jacob-rn-wallace/jpl-nanorover/README.md

<p align="center">
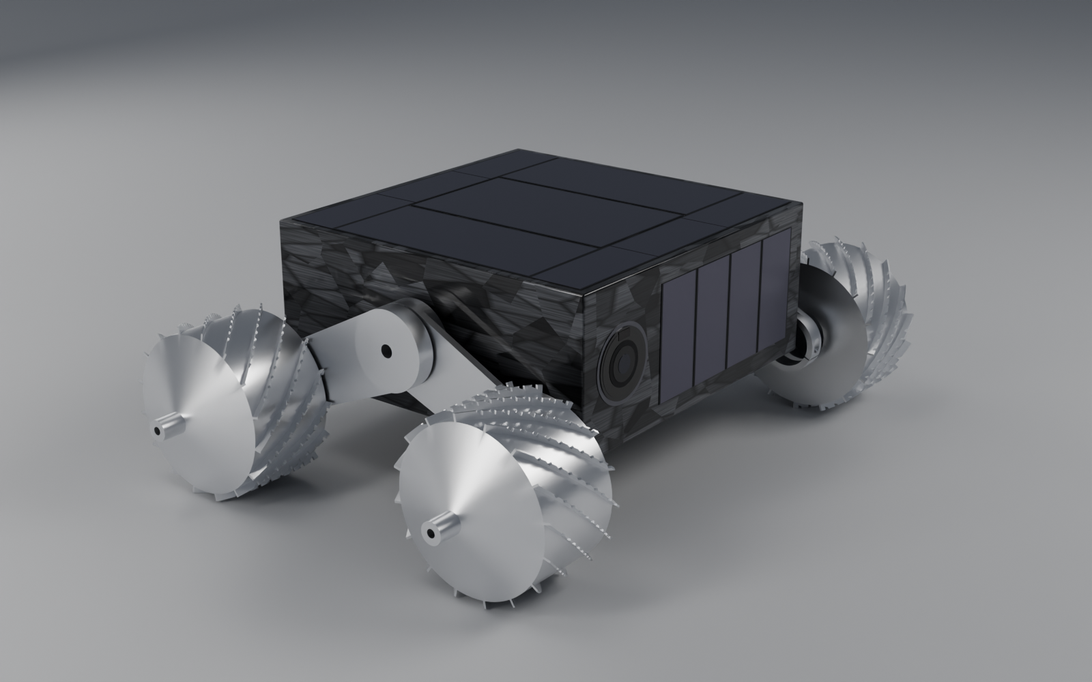
[picture p1: docs/images/rover-hero.png]
A render of the interpreted JPL nanorover: a 140 x 140 x 60 mm forged-carbon body with near-black solar cells on the lids and end faces, a round camera window on the end face, and four aluminium cleated wheels on 70 mm struts
  
</p>

# jpl-nanorover

Research toward an open replica of the JPL nanorover, the small four-wheeled asteroid rover designed for the Japanese MUSES-C (Hayabusa) sample-return mission and cancelled by NASA in November 2000.

The project is now an **interpretation** of the nanorover rather than a strict replica: it keeps the original's overall character, its 140 x 140 x 60 mm body, 70 mm struts and 65 mm wheels and its non-science functions (driving on four wheels, posing its four struts independently, self-righting, solar power and a camera), and chooses functionality, aesthetics and the spirit of mid-1990s to early-2000s hobby and academic robotics (a single controller, smart sensors on a serial link, a simple radio) over copying the originals' details. It is a teleoperated rover: it sends compact sensor data to an operator console that builds a low-fidelity 3D map, and sends a photograph on request. Spaceflight readiness is not a goal, and neither is the science payload (the IR spectrometer and so on) beyond what is needed to look right.

> **Status (2026-11-14): design on paper and in CAD; nothing is built or ordered, and purchasing is deferred.** The drivetrain is designed and modelled (Feetech servos at the hub, Pololu gearmotors in aluminium wheels). The body is being redesigned in forged carbon: it exists as a solid block with the components cut out of it, and a render stand-in (the Hammond box in the older assembly CAD is superseded). Most of the rover's own hardware is now named, with each figure tagged by how well it is sourced: [`docs/hardware-spec.md`](docs/hardware-spec.md) (controller, radio, battery, charger, sensors, drivers, camera window) and [`docs/mechanical-spec.md`](docs/mechanical-spec.md) (retention, couplings, cables, strut stops). The operator-console simulation runs in a browser. Scale, how the body is made, the lid joint and the end use are undecided; several details are labelled assumptions, not published figures.

## Target
The reference units are the two built JPL prototypes in the photographs and videos: a silver-bodied unit (a round imaging window and a sealed-beam headlamp on one end face) and a black-bodied unit (a square camera window), which share their struts and wheels. Measured against a quarter in one photo, the black unit is about
139 x 139 mm on top with wheels about 59 mm across and struts about 76 mm, and the silver unit about 125 x 140 x 55 mm. The MUSES-CN papers give a 14 x 14 x 6 cm body, 6.5 cm wheels and 7 cm struts, and win by default where the units do not agree with each other
independently (`docs/design-comparison.md`); the units differ from the papers by 8 to 11%. Solar cells on four of six faces and about 1.3 kg stay as published reference. Wheel tread, strut cross-section, hub detail and finish are not published and are scaled from photographs.
Every figure is marked with how well it is sourced, and conflicting figures are listed.

## What's here
| Path | Contents |
|---|---|
| [`docs/jpl-nanorover-literature.md`](docs/jpl-nanorover-literature.md) | Annotated bibliography, specification table with verification levels, image sources and the list of conflicting figures |
| [`docs/body-spec.md`](docs/body-spec.md), [`strut-spec.md`](docs/strut-spec.md), [`wheel-spec.md`](docs/wheel-spec.md) | The CAD design decisions: what is sourced, what is measured from the photo, what is assumed, and the checks |
| [`docs/handover.md`](docs/handover.md) | Where the project stands: sources, decisions, open questions, CAD status, corrections made and next steps |
| [`docs/hardware-spec.md`](docs/hardware-spec.md), [`mechanical-spec.md`](docs/mechanical-spec.md) | The rover's chosen hardware (parts, sources, what is verified and what is assumed) and the mechanical details (retention, couplings, seals, cables, strut stops, the lid joint) |
| [`docs/body-redesign.md`](docs/body-redesign.md) | The carbon body: layout, cells, windows, mass, the block-with-cavities method; scripts in [`hardware/body/`](hardware/body/) |
| [`docs/positioning.md`](docs/positioning.md) | Absolute positioning options (ultrasonic, Lighthouse via the solar cells, GNSS dropped) and the antennas |
| [`docs/drivetrain-spec.md`](docs/drivetrain-spec.md), [`chassis-simulation.md`](docs/chassis-simulation.md) | The drivetrain (torque and mass budget, motors, coaxial hub) and the planar chassis simulation (stances, tipping, self-righting) |
| [`docs/blender-render.md`](docs/blender-render.md), [`render-jobs.md`](docs/render-jobs.md) | The Blender renders (setup, what is modelled) and the job list that hands renders from the modelling session to the render session |
| [`docs/design-comparison.md`](docs/design-comparison.md) | The three designs in the sources (the published design and the two photographed units), side by side, with what the CAD is today and what choosing would change |
| [`docs/toy-version-notes.md`](docs/toy-version-notes.md) | A side discussion: could a stripped nanorover have been a toy around 2000, and should the project pivot (with sources) |
| [`docs/smaller-than-nanorover.md`](docs/smaller-than-nanorover.md) | A side question: what the sources say about rovers smaller than the nanorover (the 10 to 100 g task goal, widget boards) |
| [`docs/era-of-robotics.md`](docs/era-of-robotics.md) | Research on the late 1990s to early 2000s robotics scene (Handy Board, Rug Warrior, Stamp, RCX, BEAM, CMUcam, Brooks): what the "spirit" is, how today differs, candidate design rules |
| [`docs/electronics-concept.md`](docs/electronics-concept.md) | The electronics principle (the spirit of the Handy Board and CMUcam era), what was found for the processor and the camera, and the open decisions |
| [`docs/sim-spec.md`](docs/sim-spec.md), [`sim/`](sim/) | A browser simulation of the operator console (three.js, Vite, TypeScript, modelled on maha-rover's): a fun test of driving the rover through a low-fidelity 3D map with photographs on request; spec, findings and how to run it |
| [`docs/photo-measurements.md`](docs/photo-measurements.md) | Camera solution and measurements (solar cell sizes, wheel) taken from the JPL prototype photograph |
| [`hardware/`](hardware/) | Parametric CAD (build123d, STEP output): [body](hardware/body/), [hub](hardware/hub/hub.py), [struts](hardware/strut/strut.py), [wheels](hardware/wheel/wheel.py), [assembly and renders](hardware/assembly/); power, battery and layout scripts in `hardware/body/` |

## Running the CAD
```
python3 -m venv .venv
.venv/bin/pip install -r hardware/requirements.txt
.venv/bin/python hardware/body/body.py        # then hub/hub.py, strut/strut.py, wheel/wheel.py, assembly/rover.py (the older Hammond-box assembly)
.venv/bin/python hardware/body/layout.py      # the carbon body redesign: placements, mass and balance; then body/block.py (the block with cavities)
python3 hardware/body/power_budget.py         # plain python3 scripts: power_budget.py, battery_sizing.py, hardware/strut/pivot_checks.py
```
Each script prints its checks and writes STEP files to an `out/` folder beside it. Run them from the repository root, in that order (`layout.py` before `block.py`). `body.py` needs Hammond's
1590Z090 STEP file, which is not in this repository (see [`NOTICE.md`](NOTICE.md)); it is read from the private companion repository `jpl-nanorover-private`
cloned beside this one, or from the path in `HAMMOND_1590Z090_STP`. The carbon-body scripts (`layout.py`, `block.py`) do not need it. The Blender renders are described in [`docs/blender-render.md`](docs/blender-render.md); the browser simulation runs with `npm run dev` in [`sim/`](sim/).

## Contributing
Corrections with a primary source are the most valuable contribution, especially dimensions of the hub, wheel and struts, or engineering drawings. Contact with the JPL Robotics group or JPL Archives is the only known route to authoritative dimensions.

The source papers, photographs and video, and Hammond's CAD file, are kept in a separate private repository, `jpl-nanorover-private`, because they belong to their publishers. Contributions to the CAD should come with a source or a measurement for any dimension they change; see [`CLAUDE.md`](CLAUDE.md).

## License model
- **Code** (scripts, tooling) is licensed under **Apache-2.0** (see [`LICENSE`](LICENSE)).
- **Hardware designs** (the CAD scripts and their STEP output), **mechanical documentation and bills of materials** are licensed under **CERN-OHL-S-2.0**, strongly reciprocal (see [`LICENSE-HARDWARE.txt`](LICENSE-HARDWARE.txt)).
- **Documentation** (the notes in `docs/`, READMEs) is licensed under **CC BY 4.0** (see [`LICENSE-DOCUMENTATION.txt`](LICENSE-DOCUMENTATION.txt)).

See [`NOTICE.md`](NOTICE.md) for third-party material. This is an independent hobby project, not affiliated with NASA, JPL or ISAS/JAXA.
