jacob-rn-wallace/jpl-nanorover/docs/hardware-spec.md

# Hardware specification: what is chosen, what is working, what is open

Started 2026-11-13. Goal (owner, 2026-11-13): specify as much of the rover's own hardware as possible. Nothing is ordered, and purchasing is deferred indefinitely (owner), so every part here is a paper choice.

Tags: **owner** = decided by the owner; **working** = my recommendation, accepted by the owner as the working choice; **verified** = figure read from a datasheet or listing (source named); **assumed** = my estimate or memory, unchecked. The old placeholders in `hardware/body/layout.py` still carry assumed sizes and masses.

## 1. Chosen (owner or working)

| Subsystem | Part | Tag | Notes |
|---|---|---|---|
| Controller | **Microchip PIC32MX250F128D (44-pin TQFP or QFN)**, replacing the 28-pin F128B | owner (family), pin count working (2026-11-13) | Same family, 128 KB flash and 32 KB RAM, 13 analogue inputs, 34 I/O, five output-compare modules (verified in the family datasheet, section 7). Current 20 mA typical at 40 MHz (verified, Table 29-5). See 6 and 7. |
| Radio | Digi XBee 3 802.15.4, non-PRO, U.FL (XB3-24AUM-J) | owner | 40 mA transmit at +8 dBm, 15 mA receive, 2 uA power-down (not from the full datasheet table). Not ordered. |
| Antenna | Taoglas WPC.25A.07.0150C patch, 25 x 25 x 5.5 mm | owner | Behind a flush 27 mm square RF window in the -y face. Not ordered. |
| Strut servos (4) | Feetech STS3215, 12 V variant (C018 or C047) | owner | 30 kg.cm stall (verified, [Core Electronics datasheet](https://core-electronics.com.au/attachments/uploads/sts3215-smart-servo-datasheet-translated.pdf)); 2.7 A stall and 180 mA no-load at 12 V; 45.2 x 24.7 x 35 mm; about 55 g; 12-bit magnetic encoder with position, load, current and temperature feedback ([listing](https://servodatabase.com/servo/feetech/sts3215)). Listings disagree on sub-model codes, so check the exact code at purchase. |
| Wheel motors (4) | Pololu #3068 gearmotor, 10 x 12 x 25 mm | owner | No encoder. See 2. |
| Solar cells | Anysolar IXOLAR: 6 x SM940K09L, 2 x SM401K08TF, 1 x SM531K08TFS per lid; four SM940K09L per end face | owner | Each part has Vmpp about 4.5 to 5 V (SM940K09L 5.02 V, 36.6 mA; SM531K08TFS 4.46 V, 205 mA; `docs/body-redesign.md`, preliminary datasheets). |
| Charger | **TI BQ25185**, 1-cell, 1 A linear charger with power path | working (2026-11-13) | See 3. |
| Wheel counting | **Back-EMF counting** | owner (2026-11-13) | See 2. |
| Battery cell | **1S LiPo, 1000 mAh, 25C class: Overlander SKU 2809** (retailer listings: 3.7 V, 25C constant and 50C burst; about 48 x 30 x 9 mm and 28.5 g, or 50 x 31 x 9 mm and 28 g) | working (2026-11-13) | See 4. Datasheet not retrieved (Overlander's pages returned 404); protection circuit not confirmed, so assume none. |
| Servo and wheel rail | **TI TPS61288** boost to about 7.4 V | working (2026-11-13) | See 4. |
| Logic rail | **TI TPS63802** buck-boost to 3.3 V | working (2026-11-13) | See 4. |

## 2. Wheel counting: back-EMF (owner, 2026-11-13)

The wheel motors carry no encoders, and there is no room for one in the 10 mm motor envelope, so wheel travel is counted from the motor's back-EMF.

- **Method (assumed, to be worked out):** the H-bridge briefly opens (a short coast gap each PWM period), the controller reads the motor terminal voltage, and the speed follows from it (EMF is proportional to speed). Counts come from integrating speed over time.
- **Consequences to model (assumed):** poor accuracy at low speed and near stall, a direction sign taken from the drive command, and drift from the motor constant changing with temperature and battery sag. This is odometry error the sim does not yet have (open item in the handover: wheel slip and scale errors). When the sim gets them, back-EMF counting should be a separate, larger error than an encoder would give.
- **Needs from hardware:** an ADC channel per motor (the PIC32MX250 has 10-bit ADC channels; the count needed is the open pin-allocation question) or a bridge with a sense output.
- **Era fit:** the period's hobby and academic robots (Handy Board class) counted wheels with cheap sensors or inferred speed from motor current. Back-EMF is in that spirit.

## 3. Charger: TI BQ25185 (working, 2026-11-13)

- **What it is (verified from TI's listings):** BQ25185 1-cell, 1 A standalone linear battery charger with power path, factory mode and battery-tracking VINDPM; input 3.0 to 18 V (25 V tolerant); charge current 5 mA to 1 A set by the ISET pin; input current limit 100, 500 or 1100 mA set by the ILIM/VSET pin; system output up to 3.125 A, regulated at 4.5 V; VINDPM tracks the battery with a 330 mV offset when VBAT is above 3.5 V ([TI datasheet](https://focus.ti.com/document-viewer/bq25185/datasheet), [product page](https://ti.com/product/BQ25185)).
- **Cell wiring (my proposal):** put all nine cell parts of both lids in parallel, one rail of about 4.5 to 5 V, behind a diode per lid so that a shaded lid does not load a lit one. The SM531K08TFS (4.46 V) will pull the 5.02 V parts down slightly; accepted.
- **Why this part (my reasoning):** the input voltage regulation backs the charger off in dim light instead of collapsing the cell voltage, which is a crude maximum-power-point control; a lid is about 3 W in full sun (about 0.6 A at 5 V, my estimate from the datasheet figures) and tens of mW indoors, inside the 1 A limit; it needs no inductor.
- **Rejected:** BQ25570 (output at most about 110 mA, built for a single small cell; [datasheet](https://cdn.sparkfun.com/assets/a/a/9/0/8/bq25570_Datasheet.pdf)); BQ24074 as the fallback (1.5 A; its input regulation threshold is not battery-tracking; [datasheet](https://www.ti.com/lit/gpn/bq24074)).
- **Not verified:** solar and MPPT behaviour in the full datasheet (SLUSF65), the package size (my "2 x 2 mm" was from memory), and the minimum useful input. A linear charger from 5 V to a 3.7 V battery wastes about a quarter of the power as heat (my arithmetic).

## 4. Battery sizing (`hardware/body/battery_sizing.py`, 2026-11-13)

**Correction to my earlier statement.** I said a 1S 500 mAh cell could not feed the servos because the STS3215 draws 2.7 A at 12 V, "about 9 A at the battery". That was the locked-rotor current, which the loads never need: the strut loads (172 mN.m to hold, 343 mN.m to push with a pair, `docs/drivetrain-spec.md`) are about 6 to 12% of the 2.94 N.m stall torque, so the servo current is about 0.16 to 0.32 A per servo (torque / 1.09 N.m per A, assuming linear torque and current, an assumption), and the battery supplies the winding loss, not V times that current. The firmware must still limit servo torque so that a jam cannot reach the stall current.

**Result (my model, assumed figures noted in the script):** battery-side load, before converter loss:

| Case | x1 load margin | x2 load margin (idle 30 mA) |
|---|---|---|
| Driving, struts holding (wheels, camera, controller, radio) | 1.6 to 4.2 W | 4.1 W |
| Posing one strut | 1.4 to 4.0 W | 4.1 W |
| Self-righting (one pair pushing, two holding) | 2.3 to 4.9 W | 7.5 W |

The range in the x1 column is the servo idle current, which the sources disagree on: 6 mA (Feetech datasheet, machine-translated; [servodatabase](https://servodatabase.com/servo/feetech/sts3215) 60 mA) or 30 mA ([DFRobot](https://www.dfrobot.com/product-2962.html)). **Four servos idling cost 0.3 W at 6 mA and 2.9 W at 60 mA, so the idle current, not the lifting, sets the running power.** It is the first thing to measure when hardware exists, and two firmware levers exist: torque off between moves (if the 345:1 gearing holds a pose unpowered, unverified) and a lower supply voltage.

**Options at the worst realistic case (self-right at x2 margin, idle 30 mA, 85% converters):**

| Option | Energy | Peak at the pack | C-rate | Driving hours |
|---|---|---|---|---|
| 1S 500 mAh, servos on 12 V boost | 1.85 Wh | 2.9 A | 5.9 C | 0.6 |
| 1S 1000 mAh, servos on 12 V boost | 3.70 Wh | 2.9 A | 2.9 C | 1.1 |
| 1S 1000 mAh, servos on 7.4 V boost | 3.70 Wh | 2.7 A | 2.7 C | 1.4 |
| 2S 500 mAh, servos straight off the pack | 3.70 Wh | 1.2 A | 2.4 C | 1.6 |

**Room (assumed 400 Wh/L pouch cell, from memory):** the placeholder bay (5 x 30 x 24 mm) holds about 1.4 Wh (390 mAh), too small; the whole 16 mm gap between the servo pairs (16 x 30 x 24 mm) holds about 4.6 Wh (1250 mAh at 3.7 V). The battery placeholder in `layout.py` should grow to that gap.

**Working recommendation (mine, awaiting the owner's word):**
- **1S, about 1000 mAh, 3C or better, filling the 16 mm gap**, in place of the 12 g, 500 mAh placeholder (about 20 g; to be settled when a real cell is chosen).
- **One boost converter to about 7.4 V for the servos and wheel drivers.** The STS3215's listed range is 4 to 14 V, so 12 V is not needed; at 7.4 V stall torque is about 1.8 N.m (my scaling, 2.6 times the largest need with margin) and speed about 60% of the 12 V figure (to be checked against the posing time).
- **A 3.3 V buck-boost for the logic** (a 1S pack falls to 3.0 V, too low for an LDO at 3.3 V).
- **The BQ25185 stays** as the charger (1S, 1 A), so the cell wiring in section 3 stands.
- **2S rejected for now:** it would halve the peak pack current and drop the servo boost, but the 5 V cell string cannot charge a 2S pack without a boost-charger, which is more parts than the one boost it saves.
- **Not checked:** the wheel motors' supply voltage (the docs give their no-load current at 6 V; they may run straight from the 1S pack or from the 7.4 V rail through PWM), and which 1S cell supplies 3C in this size.
**Picks (2026-11-13, working choices; figures are from TI's pages and retailer listings, not the full datasheets):**
- **Cell: Overlander SKU 2809, 1S 1000 mAh, 25C constant and 50C burst.** The 25C rating is far more than the 2.7 A (2.7C) worst case needs; the point is that a small cell of this kind exists at 1000 mAh with real discharge headroom. It lies in the 16 mm gap (10 x 51 x 31 mm box in `layout.py`, thickness along x), 28.5 g instead of the 12 g placeholder: **the body contents are now over the 386 g budget by 51 g** (was 35 g); the budget is deferred (owner). **Rejected:** the DNK602272 (74 x 22 x 6 mm, 16.7 g, 1000 mAh, with a protection circuit) because its sheet gives only 1C maximum continuous (1 A) and 3C for 10 ms, and its protection trips at 3 to 5 A ([DNK sheet](https://www.dnkpower.com/wp-content/uploads/2023/11/DNK602272-3.7V-1000mAh-Lipo-Battery-Specification.pdf)); our worst case is 2.7 A for self-righting and about 1.4 A at the unmargined load. A cell with a protection circuit and a higher rate is the thing to look for if a cell without protection is unwelcome. **Needed:** a protection circuit (over-discharge, over-current, short) on the power board; the cell is assumed to have none. Capacity check: 1.0 Ah at 3.7 V is 3.7 Wh, about 95 min of driving (`power_budget.py`, scenario D).
- **Servo and wheel rail: TPS61288** (TI, [product page](https://ti.com/product/TPS61288)): input 2.0 to 18 V with 2.4 V minimum start-up, output 4.5 to 18 V, 15 A peak switch current limit, 110 uA typical quiescent current into VOUT, 2.1 uA maximum shutdown current, PFM at light load, VQFN-HR about 3 x 2 mm (the page also says 2.5 x 3.0 mm), active. At 7.4 V and 1.2 A (8.9 W) the pack side carries about 3.5 A at 3.0 V and 85% (my arithmetic), inside the switch limit. **Not confirmed:** its load disconnect (the page does not mention one: with the converter off, the input still feeds the output through the inductor and diode path, so the servos need a load switch or the converter must be enabled only when moving, to be settled in the schematic) and its maximum output current. Rejected: TPS61022 and TPS61099 (output limited to 5.5 V; [TPS61022](https://ti.com/document-viewer/TPS61022/datasheet), [TPS61099](https://www.ti.com/product/tps61099)); TPS61093 (1.6 to 6 V input, up to 17 V output, but a small-current part and I did not confirm its current limit).
- **Logic rail: TPS63802** (TI, [datasheet](https://ti.com/lit/pdf/SLVSEU9)): 1.3 to 5.5 V input (1.8 V to start), 2 A at 3.3 V for inputs of 2.3 V and up, 11 uA quiescent current, 10-pin VSON-HR (3.0 x 2.0 mm by one page, 1.4 x 2.3 mm by another). A pack down to 3.0 V is inside its range. The 3.3 V load is about 0.3 to 0.45 A (controller, radio, camera, ToF; my sum), so 2 A is generous; **the alternative is the TPS63900** (400 mA at 3.3 V, 75 nA quiescent current, 2.5 x 2.5 mm; [page](https://www.ti.com.cn/lit/gpn/TPS63900)) if the keep-alive tier of `docs/body-redesign.md` wants a very-low-quiescent rail, with the 3.3 V loads that exceed 400 mA moved to a second converter.
- **Changed with the cell:** `power_budget.py` and the sim's `batteryWh` (1.85 to 3.70 Wh; 21 sim checks pass).

## 5. Sensors and controller details (2026-11-13)

**Ranging: ST VL53L5CX (working).** Read from the datasheet itself (DS13754 rev 2, August 2021, [PDF](https://cdn.sparkfun.com/assets/6/e/3/0/6/vl53l5cx-datasheet.pdf)):
- 940 nm VCSEL, 8 x 8 or 4 x 4 zones, 63 degree diagonal square field of view, range 2 to 400 cm per zone, up to 60 Hz (15 Hz at 8 x 8, per the user manual), optical LGA16, 6.4 x 3.0 x 1.5 mm, -30 to 85 C.
- Supplies: AVDD 2.8 or 3.3 V, IOVDD 1.8, 2.8 or 3.3 V (so the 3.3 V logic rail serves both). I2C 400 kHz to 1 MHz, address 0x52; 47 kohm pull-up on the I2C reset and power-enable pins, 2.2 kohm on the clock line.
- **Current, active ranging (table 12): AVDD 45 mA typical (50 maximum) and IOVDD 50 mA typical (80 maximum); peaks are the average plus 10 mA each. Continuous ranging at 3.3 V is 313 mW (table 13).** That is 2.7 times the controller and radio together and is the biggest logic-side load. Autonomous mode at 8 x 8 and 1 Hz is 11 mW; the 5 Hz row of the table did not extract, so the sim's 5 Hz frame rate costs somewhere between 11 and 313 mW (not determined). The firmware (the ST ULD driver, which needs about 84 KB of firmware download at start-up per ST's manual: my memory, unchecked) is a load on the PIC32's 32 KB RAM and 128 KB flash to check.
- `power_budget.py` now carries the ranging load: scenario C 1.01 W, D 2.65 W, E 4.25 W; driving runtime on the 1000 mAh cell falls from 95 to 84 min.
- **Camera window, lighting and mounting (revised 2026-11-14 at the owner's idea: no beamsplitter; `layout.py`, `block.py`).** **The camera sits just behind the cover glass with a ring of white LEDs round its lens, and the ranging sensor in the ring's top slot, all behind one 26 mm circular window on the original centre (x = +48.07, z = 30), the original window size again.** This replaces the 45 degree beamsplitter plate and the separate lamp (the 28 and 36 mm windows of the earlier steps are gone).
  - **Why it is better (my analysis):** (1) the 50/50 plate passed half the light each way, so the camera and lamp together used a quarter of the light of a direct arrangement: the ring needs about a quarter of the lamp's power for the same exposure (the lamp load is now 0.1 W in `power_budget.py` and the sim, from 0.2 W; scenario C 0.91 W); (2) no ghost images from the plate and none in the ranging sensor's close range, and the datasheet's cover-glass handling now applies to one flat glass; (3) it frees the 20 mm of depth the plate and lamp used (the camera module moved forward 20.5 mm to y 57 to 66, lens front at y = 67, 1.5 mm behind the glass), so the body has more free volume; (4) 8 g (plate 3 g, lamp 5 g) become about 3 g for the ring, and the body contents fall to 434 g (over the 386 g budget by 48 g, from 53 g); (5) the camera's view no longer constrains the window, since at the glass it needs only the lens aperture; the 26 mm size is the owner's historical window, not a need.
  - **Costs (mine):** a ring of LEDs 10 mm from the lens axis lights from slightly off axis, not coaxially: at a 0.3 to 1 m working distance the shadow offset is a few mm and small, but glossy surfaces will show ring-shaped highlights; and **glare is the real risk**: the LEDs sit behind the same glass as the lens, so light can scatter in the glass into the lens. The standard fixes (as in webcams): a black printed mask ring on the glass round the lens aperture, a lens hood pressed against the glass, and the LEDs set behind the clear annulus outside it. The hood's gap and the glass thickness are to be settled; the camera's IR-cut filter behaviour is unknown.
  - **Ranging sensor:** VL53L5CX in the ring's top slot, long axis horizontal (6.4 x 3.0 mm), centre 10.5 mm above the axis (z = 40.5; top edge 12.0 mm, **0.6 mm inside the circle at the sensor's width: tight**), on the ring board (y 66 to 67.5) just behind the glass, looking +y. White LEDs are used (not infrared) so that the ring's light does not swamp the sensor's 940 nm detector, which has an infrared filter. The sim's 22 degree downward tilt would be a small wedge under the sensor board (not modelled). Answering the owner's earlier question (would rotating the sensor 90 degrees shrink the window?): not worth it, and the side position I had before it overlapped the camera's view cone by about 1.7 mm; the top slot is better.
  - **Modelled as:** a camera box (25 x 24 x 9 mm, 12 g), a ring box (23.6 x 1.5 x 16 mm standing for the ring zone, 4 g, six LEDs at about 10 mm radius at 0, 45, 135, 180, 225 and 315 degrees, the top slot left to the sensor and the bottom empty) and the sensor box (2 g); the cavities are the 26 mm through-wall cylinder (y 60 to 70) and these boxes, with no frustum and no lamp beam.
  - **Making the window read as one black disc (owner's question, 2026-11-14; recommendation mine, from general practice, unchecked): a "dead front".** Over the LED ring only, the inner face of the cover glass carries a **neutral smoked coating (about 15 to 25% transmittance, ASM)**; the rest of the window (the lens hood, the mask ring, the sensor's patch) is black. Unlit, the LEDs, which are white and yellowish even when off, vanish behind it; lit, they shine through the smoked film, as indicator LEDs do behind black fascias on consumer electronics. **Lens:** a clear aperture over the lens only (the lens looks black behind glass anyway). **Ranging sensor (corrected 2026-11-14 after reading ST's cover-glass guideline for it):** I first proposed an infrared-passing black ink over its apertures, as phones use, but ST's note says to avoid any coating on the cover glass, especially over the sensor's exclusion areas, so **the sensor's two apertures stay uncoated clear glass**, and an opaque black mask ink surrounds them (ST recommends a light blocker to break crosstalk paths through the glass). Behind clear glass the sensor's near-black package still reads as dark, so it blends in, though not as perfectly as under ink. **Cost:** only the light that leaves through the film is cut, and the scene's light returns to the camera without passing it, so the penalty is one pass: at 20% the ring needs about 5 times the power for the same exposure, about 0.25 W (the ring ran 0.05 W in my beamsplitter comparison, and the old lamp 0.2 W). The lamp is on only while a still is taken (the sim: about 1 s), so the energy cost is small (0.07 mWh a photo); `power_budget.py` and the sim now use 0.25 W. **Alternatives considered:** (a) a dark-tinted cover glass over everything: it dims the camera's ambient light by the same factor, and again for the lamp's return, so the camera suffers more than with the film over the LEDs alone; rejected. (b) infrared LEDs behind an infrared-passing black glass, as security cameras do: the LEDs are then truly invisible and the glass is black, but the stills would lose their colour (the camera's IR-cut filter would have to go) and the owner wants colour photographs as far as the docs say; rejected unless the owner chooses monochrome night stills. (c) black-bodied LEDs behind a black diffuser: similar to the smoked film; fine, but the film is simpler. **Open:** the film's actual transmittance and colour neutrality (a smoked film can tint the LEDs' white), whether the film is a printed ink or a laminated film, and whether the mask and film are made on the glass or on a separate plastic window.
  - **How much light, and the parts (2026-11-14; `hardware/body/lamp_budget.py`; recommendation mine):** my earlier lamp figures were far too dim for indicator-class LEDs, so I worked the photometry. Behind a 20% film a ring of 0603 indicator LEDs (about 300 mcd each) would put under 3 lux on a subject 0.5 m away. **Choice: six mid-power 2835-class white LEDs (3.5 x 2.8 mm; Samsung LM281B+ Pro class: about 36 lm at 65 mA and 2.7 V, from a distributor listing and Samsung's product table, not the datasheet; its maximum current is listed as 200 or 300 mA by different sources) at 25 mA each.** Six rather than seven (the top slot is the sensor's and the bottom is left empty, so the ring is symmetric left to right, at 0, 45, 135, 180, 225 and 315 degrees, 10 mm from the lens axis) so that they pair into **three series pairs on the 7.4 V rail, each with an 80 ohm resistor** (the rail is regulated, so the current follows the pair's forward voltage: plus or minus 0.4 V is plus or minus 5 mA). Result (Lambertian, a 20% film, 91 lm before and 18 lm after the film): about **65 lux at 0.3 m, 23 lux at 0.5 m and 6 lux at 1 m**, for 0.56 W from the 7.4 V rail while it is on (about 1 s a photograph; `power_budget.py` and the sim now use 0.56 W). A dim living room is about 50 lux, so the lamp is a close-range fill, not a floodlight: for a bigger range the choices are a thinner film (less invisible), more current in a pulse (the LEDs may be driven harder for a second; check the datasheet's pulse rating), or more LEDs. **Driver:** the three pairs switched together by one logic-level N-channel MOSFET (low side) on a PIC32 pin (the output-compare module OC5 can dim it; the pin must come from OC4/OC5's group, `section 7`), with a gate pull-down so that the lamp is off at reset.
  - **Cover glass (from ST's note on the VL53L5CX's cover glass, read as a third-party mirror: [guideline](https://manuals.plus/m/203bd41f6c5bb037d45ec4f749bd83f3ffd987626a16d67e63ce00b4de4e3709), not ST's own site):** the thinnest possible glass (its reference dimensions assume 0.5 mm; crosstalk rises with thickness), the highest transmittance, **no coating** over the sensor's apertures, haze under 2%, and an air gap from sensor to glass of 0.7 mm at most without a gasket (a community reply from ST staff says 0.5 mm), so **my recommendation was 0.5 mm glass, chemically strengthened (an assumption: a 26 mm disc of 0.5 mm glass is fragile unstrengthened), uncoated over the sensor and the lens, with the black mask and the smoked film printed on its inner face, and a black foam light-blocker ring round the sensor, pressed against the glass** (with the sapphire seated at y = 68.0 the air gap is 0.5 mm, see the bezel bullet below). The glass is held in a recess flush with the face. The supplier is not chosen.
  - **Sapphire instead of glass (owner's idea, 2026-11-14; my analysis and recommendation): yes, a sapphire window, but a custom disc and not a vacuum-viewport flange.**
    - **For:** sapphire is far harder than glass (Mohs 9: it will not scratch in dust or on a knock, which would otherwise degrade the camera and the ranging sensor's crosstalk), is stronger so a 0.5 mm disc is practical where 0.5 mm glass is fragile (Edmund Optics sells 0.5 mm windows as "thinner and stronger than standard glass windows"; no strength figures were found), and transmits well from 330 nm to 5.5 microns, so 940 nm is no problem. It weighs about 1.2 g for a 28 mm disc 0.5 mm thick (density 3.98 g/cm3, my arithmetic).
    - **Against:** (1) **its refractive index is 1.77 (Edmund Optics listing), so each surface reflects about 7.7% (my arithmetic) against 4% for glass: about 14% of the light is lost uncoated, and the sensor's crosstalk from the window's surfaces roughly doubles**, which ST's note links to the glass's reflection; whether that stays under the sensor's limit with the gasket and a 2 mm gap is a bench test; a visible-to-near-infrared anti-reflection coating (400 to 1000 nm, which covers 940 nm; Edmund Optics lists one for 0.5 mm windows at $139 against $116 uncoated) would recover the reflection, but ST says to avoid coatings over the sensor's apertures, so this is a trade to test, not to assume; (2) **the stock sizes do not fit:** the standard disc is 25 or 25.4 mm with a 22.5 mm clear aperture ($116, uncoated 25 mm by 0.5 mm, quantity one, Edmund Optics), but the ring of LEDs at 10 mm radius with the sensor at 10.5 mm needs a clear aperture of about 24 mm or more (the sensor's corner is 12.4 mm from the axis and the LEDs reach 11.75), so **a stock window would need the camera end shrunk, or a custom disc of about 28 mm** (price not found; custom sapphire discs are routinely made but cost more per piece); (3) **a true vacuum viewport is the wrong form:** the flanged ones (KF and CF fittings) are made for pipes, with a clear aperture of 16 mm or more across a 30 mm flange body, about 10 mm deep and tens of grams, and nothing like flush; (4) **the price:** $116 to $139 for a stock piece against a few dollars for glass; for a one-off hobby rover that is acceptable, and two or three spare windows is a real cost.
    - **Recommendation:** use sapphire, a **custom 28 mm disc, 0.5 mm thick, c-cut** (the c-axis along the view keeps its birefringence out of the picture at normal incidence; my recollection of standard windows), **uncoated first**, with a bench check of the ranging sensor's crosstalk; if the crosstalk is too high, order a VIS-NIR AR-coated one. Hold it **like a watch crystal**: a thin aluminium or stainless bezel ring (the 1.2 mm overlap the render already shows), over a black silicone gasket, flush with the face; the black mask and the smoked film are printed on the inner face as before (ink adhesion on sapphire is a question for the printer). If the cost is too high, a 0.5 mm chemically strengthened glass is the fallback. **Open:** the supplier and the price for a custom disc, the printed mask on sapphire, and the bench crosstalk test.
  - **The window bezel: a bare aluminium ring with visible screws, flush with the face (owner's taste, 2026-11-14, revised the same day to flush; in the renders and in `block.py`, not in a part CAD yet).** The owner likes the look of a metal frame with visible bolts, as on a vacuum viewport, kept flush: **a ring of bare machined 6061 aluminium (the finish of the struts), 13 mm inside radius, 18 mm outside radius, 1.5 mm thick, sitting in a 1.5 mm pocket so that its face is flush with the carbon (y 68.5 to 70), clamping the 28 mm sapphire disc (it overlaps the disc by 1 mm) onto a black silicone gasket, held by six countersunk M1.6 stainless screws (flat heads, about 3 mm across, so flush with the ring) on a 15.5 mm radius at 30, 90, 150, 210, 270 and 330 degrees** (one at the top and one at the bottom; the ring clears the end-face cells, which stop 3.9 mm away, and the face edge, 3.9 mm away). **The stack from outside (y):** ring 68.5 to 70.0; sapphire 68.0 to 68.5 in a 14.1 mm radius seat; gasket 67.7 to 68.0 on the seat (r 14.1 to 13); the through-opening is r = 13 behind. `block.py` cuts the 18 mm pocket (68.5 to 70) and the 14.1 mm seat (67.7 to 68.5) as cavities (the STEP still re-imports as one solid). **A consequence that helps: the sapphire now sits at y = 68.0, 0.5 mm in front of the ranging sensor's front face (y 67.5), inside ST's 0.5 to 0.7 mm limit for an air gap without a gasket** (the earlier layout left 2 mm); a black foam light-blocker ring round the sensor is still the rule. **What it needs in the carbon:** the shell is 1.5 mm, which the pocket (1.5 mm deep) removes entirely at the window, so the forged body needs **a moulded boss ring round the window, r = 13 to 18 mm and 4 mm deep (y 66 to 70), with six threaded inserts moulded in** (the forged route can mould in bosses, `body-redesign.md`): below the pocket the boss gives 2.5 mm of material under the ring, and the screws (M1.6 x 5) reach 3.5 mm into it, 2.2 diameters of engagement, near the 2.5 diameters wanted; blind inserts keep the tips inside the boss. I checked that it clears everything placed: the LED ring box reaches r = 11.8, the sensor box 3.5 mm from the axis, the camera box is behind at y up to 66, and the through-opening is r = 13. **Mass:** about 2.6 g for the ring, screws and inserts, and the sapphire 1.2 g (my arithmetic). **Trade-offs:** the sapphire is recessed 1.5 mm behind the ring's face and its lip (which the owner may like: a deep-set window), and the lip trims the field of view slightly: the ranging sensor's field edge passes within about 0.2 mm of the ring's inner edge at its worst (the sim tilts it downward, which helps), and a bright inner edge could reflect light into the ranging sensor (a satin black anodised inner chamfer is the fix if the bench shows it). The sapphire is replaceable (six screws). Render: `rover-window.png`, `rover-detail.png`.
  - **Open:** the cover-glass material and thickness (the datasheet's histogram handles glass crosstalk beyond 60 cm; closer glass needs ST's cover-glass guide), the sensor-to-glass gap (the box stands about 1 mm off the wall's inner face; it should sit against the glass with a spacer), the ring's driver (an LED driver with a PWM or on-off pin on the PIC32, or a MOSFET on the 3.3 V rail: unspecified, and the pin count is tight), the LED part (a 0603 or 0402 white LED; not chosen), the camera's lens barrel length (the module box ignores it), whether the camera sees the 940 nm light (an IR-cut filter would hide it).

**Inertial: TDK ICM-42688-P (working).** [TDK page](https://invensense.tdk.com/products/icm-42688-p/): 2.8 mdps/rtHz gyro noise, 70 ug/rtHz accelerometer noise, 0.88 mA in low-noise 6-axis mode, 2.5 x 3 x 0.91 mm LGA-14; supply 1.71 to 3.6 V for both VDD and VDDIO, SPI to 24 MHz, I2C to 1 MHz, I3C to 12.5 MHz (secondary listings, datasheet DS-000347 not read in full). Gyro full scale of 2000 dps and accelerometer 16 g are listed. Runs from the 3.3 V rail; I2C or SPI both possible.

**Controller: PIC32MX250F128B pin budget (distributor listings, not the datasheet; to confirm).** 28-pin SPDIP or SOIC (21 I/O), two UARTs, two SPI, two I2C, peripheral pin select, 9 or 10 ADC channels (sources differ), five output-compare (PWM) channels by one listing. Proposed allocation: UART1 to the XBee (up to 250 kbit/s is well inside the 12.5 Mbps limit), UART2 to the servo bus (half duplex, 1 Mbaud, needs a direction control or a one-wire trick), I2C1 for the VL53L5CX and ICM-42688-P (two devices, different addresses), output-compare PWM for the four wheel drivers (a bridge per motor needs two inputs, so eight outputs, or a driver with a direction pin and PWM: four PWM plus four direction), ADC channels for the four back-EMF sensors plus battery voltage and cell current (six, within the nine or ten). That uses most of the 21 I/O; **it is tight and must be counted against the real pin table before the board is fixed.**

## 6. Wheel drivers, servo bus, operator radio (2026-11-13)

**Wheel motor, corrected: the Pololu #3068 is 248.98:1, not 256:1** ([Pololu specs](https://www.pololu.com/product/3068/specs), via search summaries): 6 V nominal, 130 rpm no-load (+-20%), 0.15 A no-load, 1.5 A stall, 3.2 kg.cm stall (0.31 N.m), 1.1 W maximum output power, 10 x 12 x 25 mm, 3 mm D shaft, no encoder. Any place in the docs that calls it 256:1 (the maxon GPX) is the earlier motor. At 65 mm wheels, 130 rpm would be 0.44 m/s; the 40 mm/s driving target is about 12 rpm, about 9% of no-load speed, so the motor runs at low duty. Stall is 4 ohm (6 V / 1.5 A); a 27 mN.m slope load is about 0.15 A above no-load and the 138 mN.m step about 0.7 A (linear torque and current, my assumption).

**Wheel driver: TI DRV8837, one per motor (working).** 1.8 A, motor supply 0 to 11 V by TI's page (1.8 to 11 V in an older datasheet), logic 1.8 to 7 V, IN1/IN2 control, 120 nA maximum sleep current by TI (distributor listings 35 nA typical), 8-pin WSON 2.0 x 2.0 mm ([TI page](https://www.ti.com/product/DRV8837/part-details/DRV8837DSGR); datasheet SLVSBA4F not read in full). Rejected: the DRV8838 (PH/EN control): its enable-low state is, as I recall, a brake, which cannot be used for back-EMF sensing (to confirm in the datasheet).
- **Why this suits back-EMF counting (my reasoning, from the remembered IN1/IN2 table: 0,0 high-impedance coast; 1,0 and 0,1 drive; 1,1 brake; to confirm in the datasheet):** driving forward as PWM on IN1 with IN2 low makes the off-time of every PWM period a coast gap, so the motor terminal floats and shows its back-EMF there, which the ADC samples through a divider. At the 12 rpm target the EMF is about 0.55 V (6 V x 12/130), against a 3.2 mV step on a 10-bit, 3.3 V ADC: 0.6% of that speed per count.
- **Rail:** the drivers sit on the 7.4 V servo rail, so the firmware must cap the average motor voltage at 6 V (about 81% duty). The motors are 6 V parts.
- **Reverse:** needs PWM on IN2 with IN1 low. The PIC32MX250 has five output-compare channels and PPS can remap an output pin at run time, so one channel per motor can be moved between IN1 and IN2 with the direction; this needs both pins of each driver in that channel's PPS output group (to check against the pin table).

**Servo bus interface (working, not a part number yet).** The STS3215 is a half-duplex UART bus, 8N1, 1 Mbps default, up to 253 servos on one line, TTL-level (search summaries; the logic voltage is not stated). The PIC32's UART runs to 12.5 Mbps (listing), so 1 Mbps is no problem. A bare TX-to-bus wiring is reported not to read back reliably (an ESP32 forum user could move the servo but not read it), so the interface needs a direction control: **a single tri-state buffer (such as a 74LVC1G125) driving the bus line from TX, enabled only while sending, with RX tied to the line** (my proposal; the search did not confirm that part; the Waveshare Bus Servo Driver HAT is a ready reference for the circuit). It costs one extra pin for the enable, or the enable can be driven from the UART's own TX-enable if the PIC32 UART offers it (to check). Servo pull-up and logic level need checking against the servo's documentation; the 3.3 V logic rail may need a level shifter if the servo's bus is 5 V.

**Operator-side radio (working).** A second XBee 3 802.15.4 on the console end, joined to the same PAN and channel. The USB adapter that Digi lists is the **XU3-A11** (XBee 3 USB adapter, 250 kbps, about 115 to 128 USD by distributor listings; the earlier XBIB-U-DEV is obsolete) ([DigiKey](https://www.digikey.ph/en/products/detail/digi/XU3-A11/10292355)); a cheaper route is a bare XBee 3 on a USB-serial breakout (SparkFun lists an XBee 3 Thing Plus at 56.50 USD, [SparkFun](https://www.sparkfun.com/sparkfun-thing-plus-xbee3-micro-u-fl.html)). The console (browser, Web Serial) sees a serial port either way. Purchasing is deferred, so this is for the record.

**Pin budget, recounted with the above (finding): the 28-pin PIC32MX250F128B has 21 I/O and does not fit.** XBee UART 2, servo-bus UART 2 plus 1 direction, I2C 2, wheel drivers 8 (IN1 and IN2 for four motors) plus a shared nSLEEP, ADC 6 (four back-EMF, battery voltage, cell current), the XBee's sleep and reset lines (2): about 25, with programming pins on top. **Decision (mine, 2026-11-13, the owner trusts my judgement on this kind of call): move to the 44-pin PIC32MX250F128D in the same family.** Listings give 31 to 34 I/O (a family table 34, Farnell tables 33 and 31) and up to 13 analogue inputs ([listing](https://www.embeddedrelated.com/parts/p/PIC32MX250F128D-I/PT)); the pin need is about 25 plus programming, so even 31 fits with a few spare. It keeps the single-controller, same-family idea and the 32 KB RAM, and costs only package size (a TQFP-44 is 10 x 10 mm; the QFN-44 is 8 x 8 mm). Considered and rejected: multiplexing the ADC inputs through an analogue switch (an extra part and a slower sampling schedule for the back-EMF gaps). Still to confirm in the datasheet: the exact I/O count and the output-compare count.

## 7. Datasheet confirmations (2026-11-14)

Read from the datasheets themselves (downloaded and read as text): DRV8837/DRV8838 (SLVSBA4C, June 2012, revised February 2014, [copy](https://users.ece.utexas.edu/~valvano/Datasheets/drv8838.pdf)) and PIC32MX1XX/2XX (DS61168E, 2011-2012, preliminary, [copy](https://people.ece.cornell.edu/land/courses/ece4760/PIC32/Microchip_stuff/2xx_datasheet.pdf)). Both are older revisions than TI's and Microchip's current ones; the figures below are what those revisions say.

**DRV8837 (verified).** Table 1: nSLEEP = 1 with IN1 = IN2 = 0 gives OUT1 = OUT2 = Z, **coast**; IN1 = 1, IN2 = 0 forward (H, L); IN1 = 0, IN2 = 1 reverse; IN1 = IN2 = 1 brake. So the back-EMF scheme of section 6 works as described (PWM on IN1 with IN2 low gives a coast gap in every period). **The DRV8838 (PH/EN) is confirmed unsuitable:** EN = 0 is a brake (L, L), not a coast. Also confirmed: motor supply VM 0 to 11 V, logic VCC 1.8 to 7 V (so the 3.3 V logic rail serves VCC and the 7.4 V rail serves VM; VCC and VM may be tied together only if the supply is 1.8 to 7 V, which 7.4 V is not), 1.8 A output current, 120 nA maximum sleep current, 8-pin WSON 2.0 x 2.0 mm, no VM undervoltage lockout, input pins have a weak pull-down of about 100 kohm (so a floating PIC32 pin during reset reads as low and the bridge coasts). **A new finding: the over-current protection trips at 1.9 A minimum (Table 3), and the Pololu #3068's stall current at 7.4 V is 1.85 A (7.4 V against its 4 ohm, from Pololu's 1.5 A at 6 V), so a stalled wheel at full duty runs within 0.05 A of the trip.** The 6 V average-voltage cap of section 6 (81% duty) keeps the average stall current at 1.5 A, but each PWM pulse is at 7.4 V; if the pulse current reaches 1.85 A it will sit at the trip threshold. **Recommendation (mine): keep the duty cap, add a firmware stall detector on the back-EMF (a wheel that is commanded and not turning), and accept that an OCP trip only disables the bridge and retries after tRETRY (the table says it recovers automatically), which is safe, not damaging.**

**PIC32MX250F128D (verified; the family datasheet's device table lists the F128B and F128D side by side).** 44 pins, 128 KB (plus 3 KB boot) flash, 32 KB RAM, **34 I/O pins at most for the 44-pin parts (21 for the 28-pin)**, 31 remappable pins (19 on the F128B), **five output-compare modules**, five input captures, two UARTs, two 4-wire SPI/I2S, two I2C, **13 analogue inputs on the 44-pin parts** (10 on the 28-pin), 10-bit ADC at 1.1 Msps with one sample-and-hold, 2.3 to 3.6 V, 40 MHz (50 MHz in the lower temperature range). **Operating current (Table 29-5): 20 mA typical and 30 mA maximum at 40 MHz** (CPU executing from flash, no peripherals; 15 mA at 30 MHz, 10 at 20 MHz, 7 at 10 MHz); **idle current 7.5 mA typical and 11 mA maximum at 40 MHz** (Table 29-6). So the controller figure in the power budget (0.5 mA/MHz x 40 MHz = 20 mA) is confirmed; at 20 MHz the controller would draw 10 mA, a saving of 0.033 W, if 20 MHz is enough.
- **The reverse-by-remapping idea works, with one rule (Table 11-2, output pin selection):** each output-compare module can reach only the pins of its own group: OC1: RPA0, RPB3, RPB4, RPB15, RPB7, RPC7, RPC0, RPC5; OC2: RPA1, RPB5, RPB1, RPB11, RPB8, RPA8, RPC8, RPA9; OC3: RPA3, RPB14, RPB0, RPB10, RPB9, RPC9, RPC2, RPC4; OC4 and OC5: RPA2, RPB6, RPA4, RPB13, RPB2, RPC6, RPC1, RPC3. So a motor's IN1 and IN2 must both be chosen from the same group, and four motors take OC1 to OC4, one group each, with OC5 (the same group as OC4) free for the LED ring's PWM. **Avoid RPB0 and RPB1: the pin table lists them as PGED1 and PGEC1**, the programming pins (PGED2 and PGEC2 are the other pair, and the choice decides which pins the debugger uses). Remapping an output at run time needs the PPS unlock sequence each time (fine at the rate of a direction change).
- **Pin budget:** the need counted in section 6 was about 25 plus programming pins; 34 I/O is enough with margin. The 28-pin part (21 I/O) was indeed too small.

**The cell's protection circuit (not confirmed, and a part chosen to cover it).** Overlander's pages for the SKU 2809 still returned 404 and nothing found states whether the pack has a protection circuit; the owner is to treat it as **unprotected**. The BQ25185 charger does not protect against over-discharge or over-current. **Recommendation (mine): a one-cell protection IC with a pair of FETs on the power board: TI BQ29700** (search result summaries of TI's comparison table, [TI product page](https://www.ti.com/product/BQ29700); not read in full): overvoltage 4.275 V, undervoltage 2.8 V (144 ms delay), discharge over-current at 0.100 V across the FETs (20 ms), short circuit at 0.5 V (250 us), charge over-current at -0.100 V; 4 uA normal and 100 nA shutdown current (an older revision); WSON-6, 1.5 x 1.5 mm; it drives two external FETs. **Sizing (my arithmetic): the discharge trip is 0.1 V divided by the FET pair's total on-resistance, so the 2.7 A worst-case self-righting peak and the 3 A or so of a stalled servo pair need a pair of 28 mOhm or less in total (a trip at 3.6 A) to avoid nuisance trips, and the pair should be rated for 6 A or more.** The pack's own 25C rating is far above this; the protection is for the cell's over-discharge and for a short.

## 8. Still to specify (queue, in order)

1. (Done in 5.) Ranging sensor: **ST VL53L5CX** is the candidate (verified, [datasheet](https://cdn.sparkfun.com/assets/6/e/3/0/6/vl53l5cx-datasheet.pdf): 63 degree diagonal field, 6.4 x 3.0 x 1.5 mm, 15 Hz maximum at 8 x 8 and 60 Hz at 4 x 4; about 100 mA typical and 150 mA peak on the [Pololu carrier](https://www.pololu.com/product/3417), not the bare chip). Mount high on the camera end face (sim finding).
2. (Done in 5.) Inertial sensor: **TDK ICM-42688-P** is the candidate (verified, [TDK](https://invensense.tdk.com/products/icm-42688-p/): 2.8 mdps/rtHz gyro, 70 ug/rtHz accelerometer, 0.88 mA, 2.5 x 3 x 0.91 mm). The comparison with Bosch BMI270 and ST LSM6DSO rests on one secondary table that does not name the parts.
3. Battery cell, 7.4 V boost converter and 3.3 V buck-boost (recommendation in 4; part numbers still to find).
4. (Done in 6, part of it: DRV8837 drivers; the bus buffer and the XBee USB adapter are named but unconfirmed.)
5. (Done in 6.) Operator-side radio.
6. PIC32 pin and peripheral allocation (UART for the servo bus, UART for the radio, I2C for the sensors, PWM and ADC for the drivers).
7. Mechanical: wheel and spindle-tube retention, hub gear teeth and servo mounting, seals, O-rings and lid screws, wiring feedthroughs.
8. Optional: the Lighthouse receiver amplifier (needs the SM940K09L cell layout from Anysolar, `docs/positioning.md`).

- Mechanical details (wheel fixing, tube clamp, coupling, seals, hub adapters, wire passage, strut stops, lid joint): `docs/mechanical-spec.md` (2026-11-13).
