jacob-rn-wallace/jpl-nanorover/docs/design-comparison.md

# Three designs, and what the CAD is

The project draws on three descriptions of "the JPL nanorover" that do not agree, and the CAD (`hardware/`) is a fourth, hybrid model. This page records them side by side so the choice
of what to replicate is made once, in one place. Status: **the reference unit is undecided** (owner, 2026-11-10). Until it is, the CAD keeps the papers' body and strut figures.

## The three designs

| | A. The published MUSES-CN design | B. The silver-bodied unit | C. The black-bodied unit |
|---|---|---|---|
| Where it comes from | Wilcox & Jones, Jones & Wilcox (1999 to 2000), four papers; one sentence repeated in all four: "Each strut is 7 cm long from the center of their pivot to the center of the wheel axis" | `NanoRover-hires.original.jpg` (JPL research page, "Prototype of the nanorover, only 20cm long"); **the same photograph is Figure 1 of Jones & Wilcox 2000**; shown with its body open and the optics in JPL's 1997 video | `img840-340-hires.original.jpg` (JPL gallery, "Nanorover (circa 1997)"); seen running in JPL's 1997 and 1998 videos, in a 1997 KTLA news segment (owner's statement; not viewed), and as an animation in the saved IROS'97 page |
| Role (owner's account) | the intended flight vehicle | internal test unit that carried the science optics; used to demonstrate the optical train and teleoperation | running mock-up with no instruments, used for publicity |
| Body | 14 x 14 x 6 cm, mass 1300 g | about 125 x 140 x 55 mm (hub-axis width x length x height; scaled from its wheels, which it shares with C) | about 139 x 139 x 36-44 mm (scaled from the quarter in its photo) |
| Struts | 7 cm, pivot to wheel axis | about 78 mm | about 76 mm (shared hardware with B) |
| Wheels | 6.5 cm; "a complex assembly of thin conductors and insulator" that also senses ground contact; banded cylinders in JPL's 1998 video | cone on a smooth cylinder with 16 helical serrated grousers, about 59 mm across them (from the quarter; the CAD uses the papers' 65 mm) | same as B (owner: identical struts and wheels) |
| Camera window | one on the front face, for the camera and IR spectrometer | round window, 26 mm, plus a tilted sealed-beam headlamp, on one end face | square window, about 25 x 22 mm, fixed over the opening with adhesive, on the opposite end face from B's (owner's reading) |
| Solar cells | four of six faces; the antenna on the top face | top face: 14 flat cells plus cells on a raised block; an antenna loop and a bone-shaped piece on top | top face: about 14 flat cells plus cells on a raised block |
| Finish | not stated | bare aluminium | black enclosure with a green PCB-like base seam |

Sizes in B and C are photogrammetric estimates (see `photo-measurements.md`): C's scale comes from the US quarter in its photo (the wheels, 59 mm across, follow from it), B's from the wheels it shares with C; both depend on the camera solution and are uncertain by a few percent.
The papers' wheel (6.5 cm, banded) is a different design from the units' wheel (about 59 mm, cleated), and the papers' strut/wheel ratio (1.08) differs from the units' (about 1.3).

## What the evidence says

- **The papers' own rover figure is the silver unit.** Figure 1 of Jones & Wilcox (2000) is the same photograph as `NanoRover-hires.original.jpg`: the silver body, round window, headlamp, antenna loop and the same rock. So the papers' text (14 x 14 x 6 cm, 6.5 cm wheels, 7 cm struts) is illustrated by unit B, and A and B are not independent sources. The strut figure is stated only in the four Jones/Wilcox papers (one author pair repeating one sentence); Tunstel (1999) and Weisbin (1998) do not give a strut length.
- **B and C share a drivetrain** (owner). A cross-check supports it: the strut-to-wheel ratio is 1.32 for B and 1.29 for C (scale-free) and the wheel position outboard of the body agrees to about 4 mm.
- **The quarter in C's photo gives an absolute scale** and shows the photographed wheels are about 59 mm across, not the papers' 65 mm. C's footprint (about 139 x 139 mm) equals the papers' 14 x 14 cm; its struts (about 76 mm) are about 9% longer than the papers' 7 cm. B (scaled with the same wheels) is about 125 x 140 x 55 mm: its length equals the papers' 14 cm, its width and height are 11% and 8% below the papers' 14 x 6 cm. Neither unit is exactly 14 x 14 x 6.
- **The height fits the owner's account.** The instrument stack sets B's height (about 55 mm); a mock-up without the optical bench would be thinner, as C is (about 40 mm).
- **Which was built first, and which is closer to flight, cannot be told from what has been read.** The JPL captions give only "circa 1997" for C. The 1998 animation of the flight vehicle has a round window and a rectangular panel on one end face, which resembles B more than C, but it also has banded wheels that match neither.

## What the CAD is today

A hybrid: the **papers' body size** (140 x 140 x 60 mm; C's footprint and B's length match it), the **papers' 70 mm struts**, the **units' cleated wheel** (the owner chose it over the papers' banded wheel),
**B's round window** (the headlamp is not modelled yet), and **C's-photo-derived solar cell sizes** (at the 140 mm scale; about 11% larger under the shared-drivetrain scale). It is good for fit checks and mechanics. It is not any one of A, B or C.

## There is no final nanorover: what is built, planned and conceptual

NASA cancelled the nanorover in November 2000, years before its planned launch (2002), so none of the three descriptions is a finished design; each is a snapshot of a design still being developed. The papers are written in the language of a design in progress ("the mechanical elements of the rover are being designed to 100 Gs", "the entire rover system is being qualified", "the solar cells are planned to be state of the art multijunction cells"), and the hardware in the photographs and videos is prototype hardware. What a "true" nanorover would have been after the rest of the development cycle cannot be known; the most recent snapshots are what can be copied.
Each element is therefore tagged with its status:

- **Built:** seen on hardware in a photograph or video.
- **Planned:** stated in the papers as part of the flight design, not seen built.
- **Concept:** an idea under development (a lab demonstration or a slide), not yet part of a vehicle.

| Element | Status | Where |
|---|---|---|
| Four wheels on four posable struts, struts on hubs at the centre of two opposite faces; cone and helical-grouser (cleated) aluminium wheel, about 59 mm across | Built | units B and C (photographs, 1997 and 1998 videos) |
| Round imaging window with a tilted sealed-beam headlamp on one end face; optics (camera, spectrometer) inside the body | Built | unit B (photograph, the opened body in the 1997 video) |
| Square camera window bonded over its opening; thin black enclosure on a PCB-like base | Built | unit C (photograph, videos) |
| Solar cells on the top face; a raised block with cells; an antenna loop | Built | units B and C (the loop on B only) |
| 8051-class computer, 500 g of lithium batteries (prototype electronics) | Built | the archived Brescia page and the 1998 embedded-control paper (abstract and snippets) |
| Solar cells on four of six faces, the antenna as a square patch on the top face | Planned | the papers |
| Synova R3000 flight processor, no battery, 2.3 W of sunlight power, 4800 bit/s radio, 100 g design loads | Planned | the papers |
| Optical sun detectors on all six faces, a laser range finder, a contact sensor on each strut and wheel | Planned | the papers |
| Wheels as an assembly of thin conductors and insulator that also senses the ground (banded cylinders in the 1998 animation and on a 1998 lab prototype) | Planned, with a lab demonstration | the papers; the 1998 video |
| Electroactive-polymer wipers for dust on the optical window | Concept | JPL slides (Bar-Cohen); dust tests in the 1998 video |
| A sub-100 g "even smaller Nanorover" with the Widget Board | Concept | the 1998 video narration; the nanorover task goals |

**Consequence for the replica.** The default target is the **most recent built hardware** (units B and C); planned and concept items are opt-in, chosen by the owner one at a time (the owner has chosen the cleated wheel, which is built, over the papers' planned banded wheel). This sits beside the settling rule below, which governs numerical values: the papers' dimensions win by default because they are the only complete set, even though they describe a design that was never finished.

## Rule for settling values (owner, 2026-11-10; replaces the earlier two-of-three rule)

**Rule.** The papers (A) are authoritative by default. A paper value is overridden only when the two built units (B the silver unit, C the black unit) **independently** agree on a different one. Independence is required: B and C carry the same struts and wheels (owner), so on anything that is part of the drivetrain they count as one observation, not two. B's and C's absolute sizes are also scaled from A's 65 mm wheel, so they cannot contradict A's absolute numbers on their own, only scale-free ratios and features. Ties and exceptions are decided by the owner and recorded here.

Note that the papers' own rover figure is unit B (Figure 1 of Jones & Wilcox 2000), so A and B are not independent of each other either; the rule gives the papers priority all the same.

**Applied to the values in play:**

| Value | Papers (A) | Built units | Result |
|---|---|---|---|
| Body, hub-axis width x length x height | 140 x 140 x 60 mm | B about 125 x 140 x 55, C about 139 x 139 x 40: they disagree with each other | **140 x 140 x 60 mm stands** (no independent override) |
| Strut length, pivot to wheel centre | 70 mm | B and C both about 76 to 78 mm, but shared hardware: one observation | **70 mm stands** |
| Wheel diameter | 65 mm | about 59 mm across the grousers (both units, shared hardware: one observation) | **65 mm stands** (the units' 59 mm is recorded) |
| Wheel construction | banded conductor and insulator cylinder | cleated wheel on both, shared hardware: one observation | the papers would stand; **the owner chose the cleated wheel** (an exception, 2026-11-10) |
| Struts on hubs at the centre of two opposite faces | stated | seen on both | stands |
| Solar cells | four of six faces, antenna on the top face | cells on top, antenna loop on B | the papers stand; the units show only the top face |
| Window and lamp | a view window on the front face; a headlamp is listed among the optics | B round window and headlamp, C square window | the papers say nothing on shape: **open**; the owner may choose |
| Mass | 1300 g | not measurable | stands |

The earlier two-of-three rule would also have given 140 x 140 x 60 mm; it differed only on how to count the two units (it counted a shared strut as two votes against the papers). The shared-hardware count is the amendment that keeps the strut at 70 mm.

## What choosing would change

| If the replica follows | Body | Struts | Wheel | End face |
|---|---|---|---|---|
| A, the published design | 140 x 140 x 60 | 70 mm | banded cylinder | one window |
| B, the silver unit | about 125 x 140 x 55 | about 78 mm | cleated, about 59 mm across | round window plus headlamp |
| C, the black unit | about 139 x 139 x 40 | about 76 mm | cleated, about 59 mm across | square bonded window, black finish |
| A hybrid (today; also what the rule gives, with the owner's cleated-wheel exception) | 140 x 140 x 60 | 70 mm | cleated | round window |

Choices that do not depend on the unit: four wheels on two hubs with independently posable struts, a flat sealed box, cells on top, the hub studs and the O-ring lid.

## Open questions

1. Which unit, or which design, is the replica of? (owner: not sure)
2. If B or C: strut length about 76 to 78 mm instead of 70 mm, wheels about 59 mm instead of 65 mm, and (B only) a body about 125 mm wide and 55 mm high instead of 140 x 60. The Hammond 1590Z090 box is 140 x 140 and would be about 12% too wide for B.
3. If A: the wheel would change from the cleated wheel to the banded cylinder.
4. What a "looks-like replica" should copy from C (the black finish, the square window) if the dimensions follow B.
