jacob-rn-wallace/jpl-nanorover/docs/render-jobs.md

# Render jobs (the hand-off between the modelling session and the render session)

**How this works.** Two kinds of Claude Code session share this repository. The **modelling session** (the desktop, an HP EliteDesk with no GPU) changes the CAD and the render scripts, commits and pushes. The **render session** (the owner's MacBook Air, M2, 16 GB) pulls, renders the jobs that are `pending` below, checks the images, marks the jobs `done`, commits and pushes. The render session does not change the models, the scripts or the docs other than this file and the images. If something looks wrong in a render, it records that in the job's row and leaves the fix to the modelling session.

## For the render session: what to do

1. `git pull`. Read this file and `docs/blender-render.md` ("Setup on an Apple Silicon Mac", not yet tried: if a step there fails, note it under "Notes from the render session" below).
2. Make sure Blender 4.5.9 and the two meshes (`hardware/assembly/out/blender/struts.stl`, `wheels.stl`; git-ignored) are in place.
3. Render the pending jobs: `hardware/assembly/render_all.sh` (every job) or `hardware/assembly/render_all.sh R6 R7` (just those). It prints the device and the time of each job.
4. **Look at each image** before committing it (open the PNG): check that nothing is missing, black, blown out or in the wrong place; compare with the "expected" column.
5. In the table, set `Status` to `done YYYY-MM-DD` and put the render time in the `Notes` column; if an image is wrong, leave the job `pending` and say what is wrong.
6. `git add docs/images docs/render-jobs.md && git commit && git push` (the commit message names the jobs, for example "Renders R1 to R7 on the M2 (Metal)").

## For the modelling session: what to do

When a change to the CAD, the layout, the materials or the camera alters what a render shows, set the affected jobs to `pending` (with the reason in `Why`) and add a job here and in `hardware/assembly/render_all.sh` if a new view is needed. Commit and push, then tell the owner the render session has work.

## Jobs

| Id | Image (`docs/images/`) | Settings | Expected | Why (last change) | Status | Notes |
|---|---|---|---|---|---|---|
| R1 | `rover-hero.png` | `VIEW=hero`, 1600x1000, 96 samples | camera end three-quarter view: carbon body, near-black cells, aluminium struts and wheels, the 26 mm window with the lens visible | a bare aluminium window bezel flush with the carbon face and six flush countersunk M1.6 screws, the sapphire recessed behind it (2026-11-14, owner's taste; the window view should show a flat ring with six small hex-socket heads and a visible depth to the window), six mid-power LEDs at 10 mm radius, sensor package behind clear glass; was: window redesigned 2026-11-14 (LED ring, lens, sensor; no beamsplitter); LEDs no longer drawn when off | pending | M2 Metal GPU: 36 s. |
| R2 | `rover-rear.png` | `VIEW=rear`, 1600x1000, 96 | the comms end: the square RF window plug | unchanged since 2026-11-13; re-render only to refresh | done 2026-11-14 | M2 Metal GPU: 36 s. |
| R3 | `rover-top.png` | `VIEW=top`, 1600x1000, 96 | top lid cells, camera end up | unchanged since 2026-11-13 | done 2026-11-14 | M2 Metal GPU: 36 s. |
| R4 | `rover-detail.png` | `VIEW=detail`, 1500x940, 96 | the camera-end corner: the window with lens, hood, dead-front ring (no visible LED outlines now), sensor patch above the lens, four end-face cells | a bare aluminium window bezel flush with the carbon face and six flush countersunk M1.6 screws, the sapphire recessed behind it (2026-11-14, owner's taste; the window view should show a flat ring with six small hex-socket heads and a visible depth to the window), six mid-power LEDs at 10 mm radius, sensor package behind clear glass; was: LED outlines removed (they showed as raised discs) | pending | M2 Metal GPU: 49 s. |
| R5 | `rover-cells.png` | `VIEW=cells`, 1500x940, 96 | raking close-up of the top-lid cells | unchanged since 2026-11-13 | done 2026-11-14 | M2 Metal GPU: 22 s. |
| R6 | `rover-window.png` | `VIEW=window`, 1500x940, 96 | straight-on close-up: glass, hood, lens, a smooth dark ring with no LED outlines, the small dark sensor patch at the top | a bare aluminium window bezel flush with the carbon face and six flush countersunk M1.6 screws, the sapphire recessed behind it (2026-11-14, owner's taste; the window view should show a flat ring with six small hex-socket heads and a visible depth to the window), six mid-power LEDs at 10 mm radius, sensor package behind clear glass; was: LED outlines removed | pending | M2 Metal GPU: 81 s. |
| R7 | `rover-window-lit.png` | `VIEW=window LED=on SUFFIX=-lit`, 1500x940, 96 | the same view with the six white LEDs lit (the lamp on during a photograph) | a bare aluminium window bezel flush with the carbon face and six flush countersunk M1.6 screws, the sapphire recessed behind it (2026-11-14, owner's taste; the window view should show a flat ring with six small hex-socket heads and a visible depth to the window), six mid-power LEDs at 10 mm radius, sensor package behind clear glass; was: new variant, 2026-11-14 | pending | M2 Metal GPU: 58 s. |
| R8 | `rover-window-black.png` | `VIEW=window BEZEL=black SUFFIX=-black`, 1500x940, 96 | the straight-on window close-up with the bezel ring and the six screws in a black oxide finish (dark charcoal, satin, against the glossy carbon) | owner asked to see a black oxide version of the bezel, 2026-11-14 | done 2026-11-14 (desktop, CPU, 64 samples; the Mac may redo it at 96) | Looked at: the black ring and screws nearly disappear against the glossy carbon (black on black); only a faint satin sheen and the ring's edge show. |
| R9 | `rover-detail-black.png` | `VIEW=detail BEZEL=black SUFFIX=-black`, 1500x940, 96 | the camera-end corner with the black bezel | same | pending | |
| R10 | `rover-window-gunmetal.png` | `VIEW=window BEZEL=gunmetal SUFFIX=-gunmetal`, 1500x940, 96 | the straight-on window close-up with the ring dark-grey anodised and the six screws dark stainless: reads as metal against the glossy carbon, darker than the bare aluminium | owner chose to see a gunmetal bezel, 2026-11-14 (black nearly vanished) | done 2026-11-14 (desktop, CPU, 64 samples; the Mac may redo it at 96) | Looked at: the dark-grey ring reads as metal against the carbon, the six slightly lighter screw heads and their hex sockets show clearly. |
| R11 | `rover-detail-gunmetal.png` | `VIEW=detail BEZEL=gunmetal SUFFIX=-gunmetal`, 1500x940, 96 | the camera-end corner with the gunmetal bezel | same | pending | |

## Notes from the render session

- 2026-11-14 (M2 MacBook Air): the Mac's existing `/Applications/Blender.app` was 4.1.1, which fails on the Principled BSDF "Thin Film Thickness" input (added in 4.2). Installed 4.5.9 LTS beside it (dmg SHA-256 matched `e3a3d7aa...`; copied to `~/tools/Blender-4.5.9.app`, not into /Applications) and ran with `BLENDER=$HOME/tools/Blender-4.5.9.app/Contents/MacOS/Blender hardware/assembly/render_all.sh`. `render_all.sh` picks `/Applications/Blender.app` by default, so on this Mac that variable must be set (or 4.5.9 put in /Applications).
- The venv existed, so `blender_export.py` regenerated `struts.stl` and `wheels.stl` from the STEP files without the CAD chain.
- Device reported: `METAL ['Apple M2 (GPU - 10 cores)']`. All seven jobs done; every image was opened and checked against "Expected". R6 was redone (it was the desktop's CPU test, 457 s there; 81 s here).
