jacob-rn-wallace/jpl-nanorover/docs/images/rover-cells.png

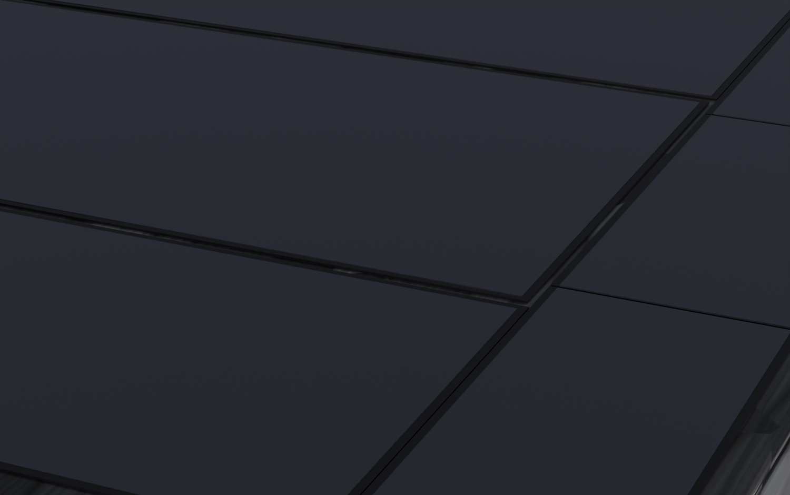
docs/images/rover-cells.png
