jacob-rn-wallace/jpl-nanorover/docs/images/rover-concept-detail.png

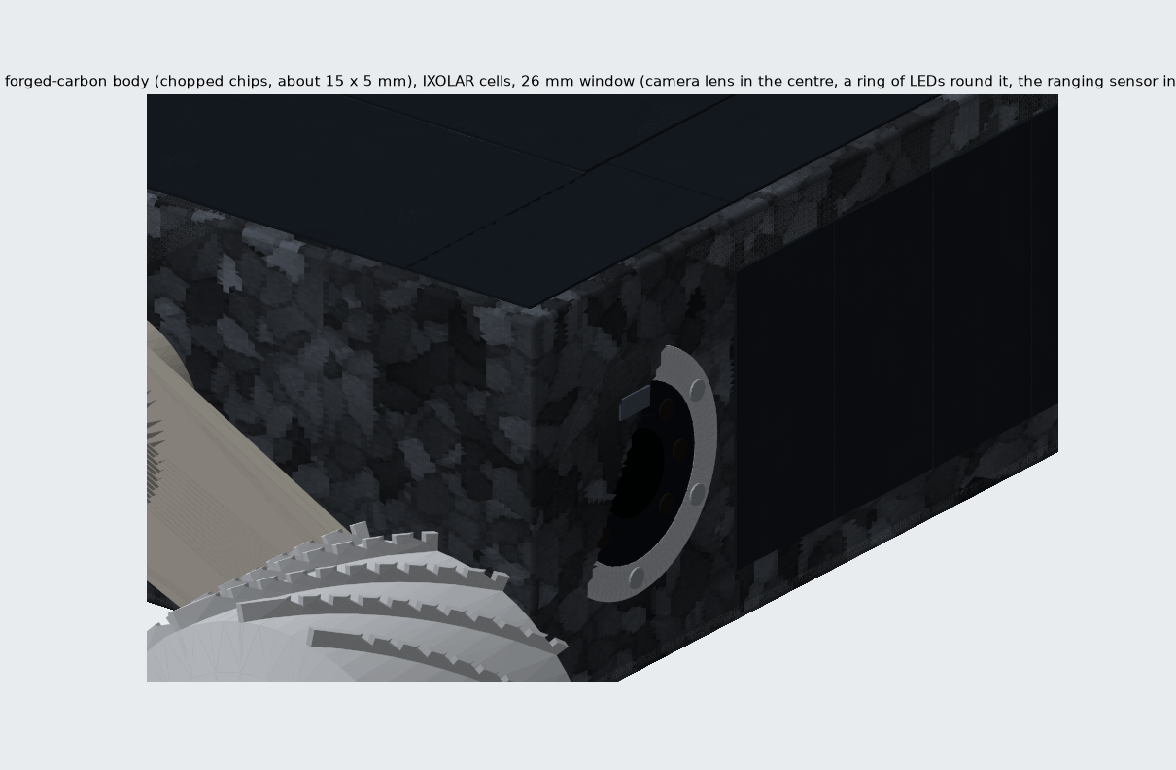
docs/images/rover-concept-detail.png
