jacob-rn-wallace/jpl-nanorover/docs/images/rover-concept-window.png

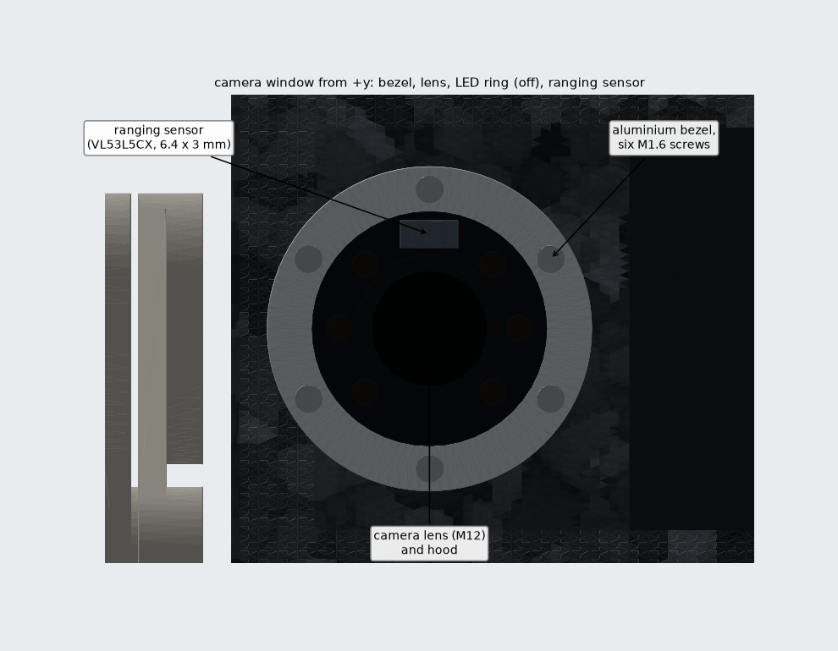
docs/images/rover-concept-window.png
