jacob-rn-wallace/jpl-nanorover/docs/images/rover-concept.png

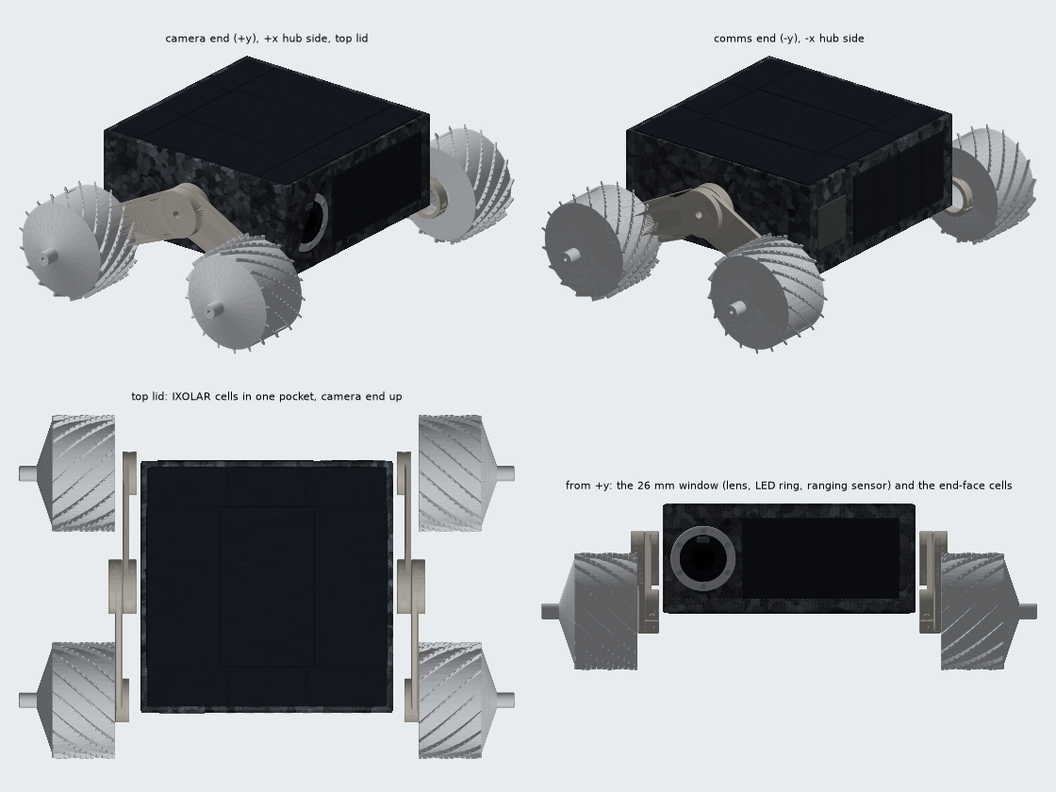
docs/images/rover-concept.png
