jacob-rn-wallace/jpl-nanorover/docs/images/rover-detail.png

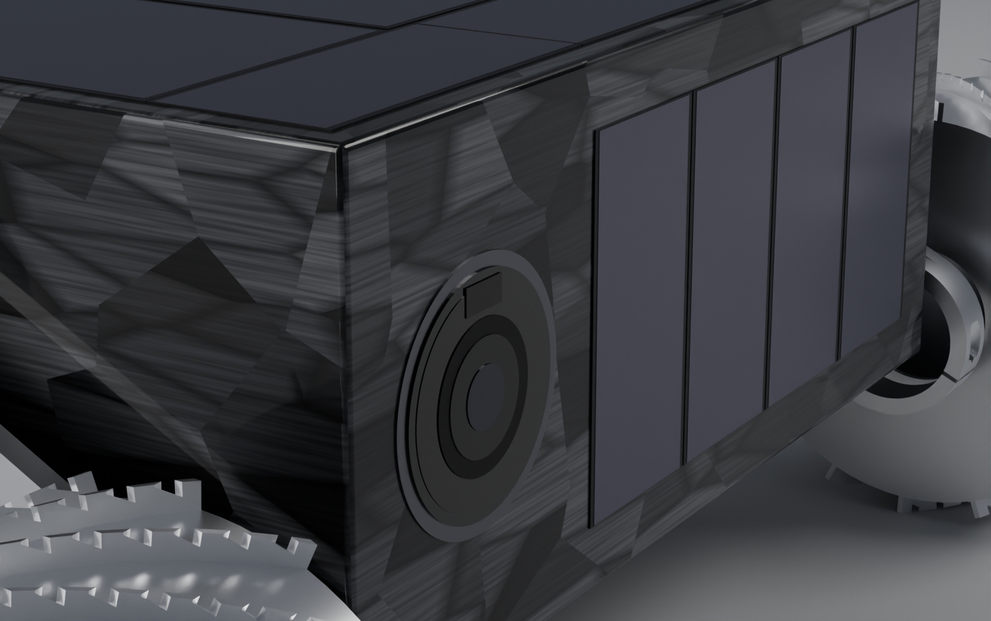
docs/images/rover-detail.png
