jacob-rn-wallace/jpl-nanorover/docs/images/rover-rear.png

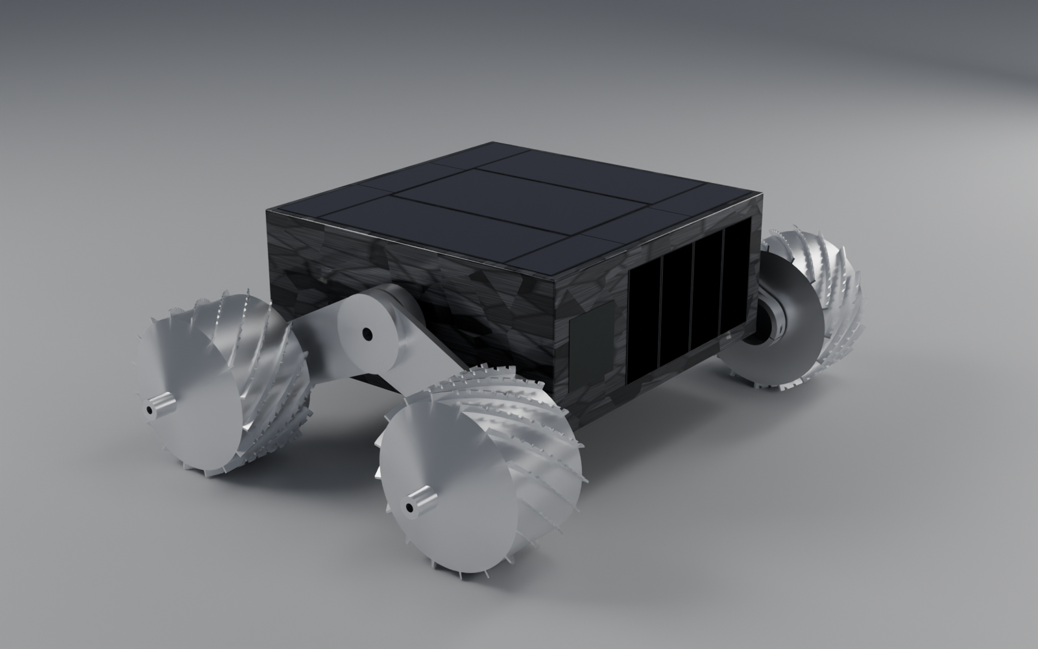
docs/images/rover-rear.png
