jacob-rn-wallace/jpl-nanorover/docs/images/rover-top.png

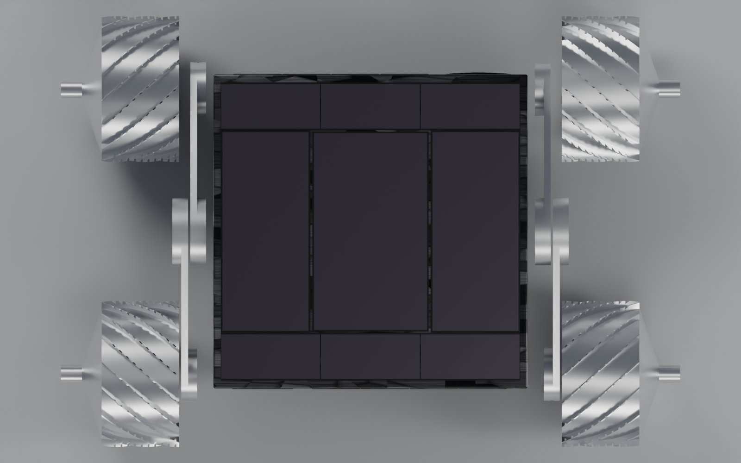
docs/images/rover-top.png
