jacob-rn-wallace/jpl-nanorover/docs/images/rover-window-black.png

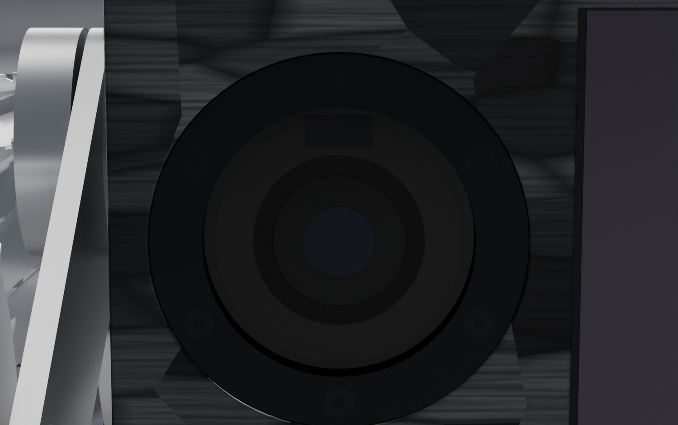
docs/images/rover-window-black.png
