jacob-rn-wallace/jpl-nanorover/docs/images/rover-window-gunmetal.png

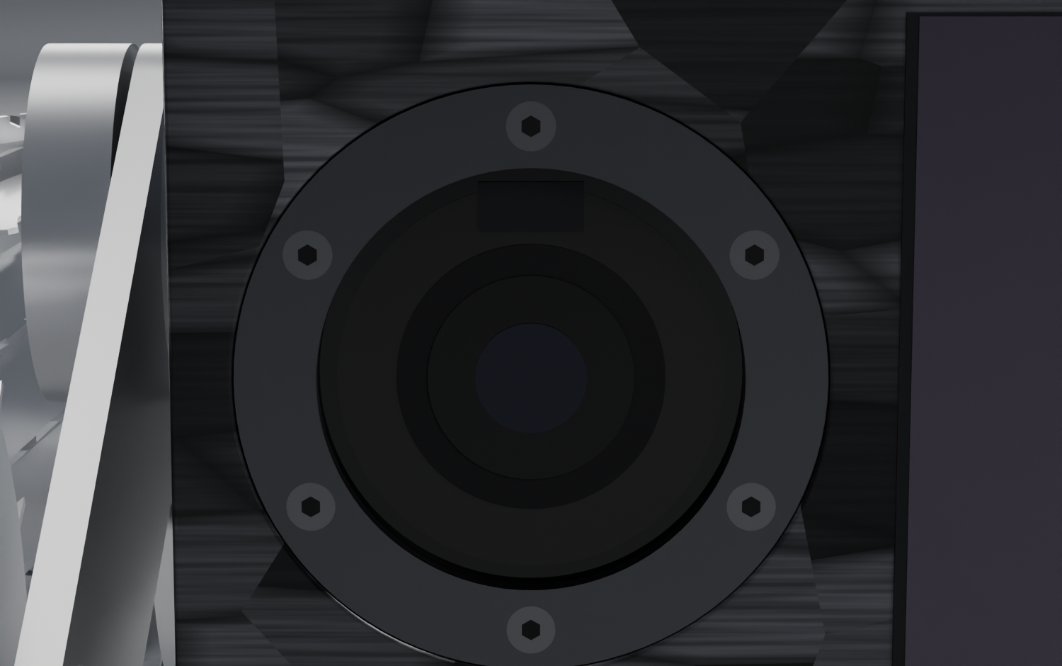
docs/images/rover-window-gunmetal.png
