jacob-rn-wallace/jpl-nanorover/docs/images/rover-window-lit.png

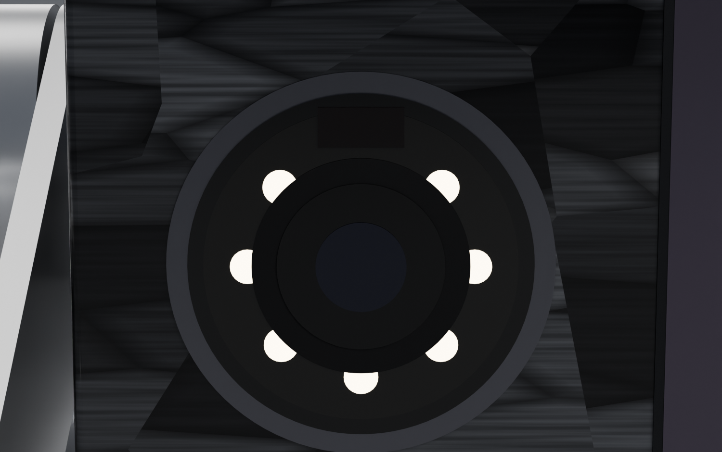
docs/images/rover-window-lit.png
