jacob-rn-wallace/jpl-nanorover/docs/images/rover-window.png

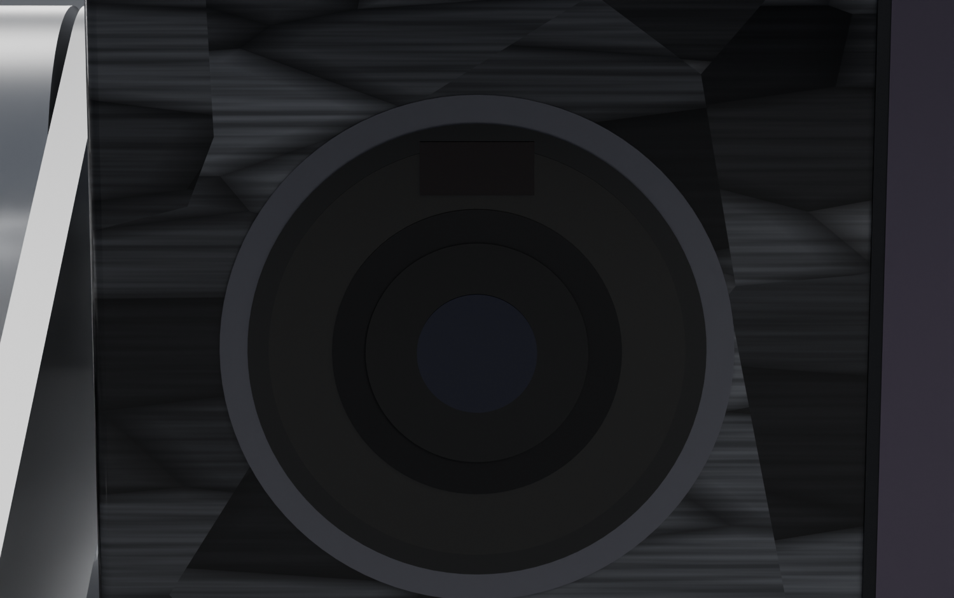
docs/images/rover-window.png
