jacob-rn-wallace/jpl-nanorover/docs/images/ultrasonic-sites.png

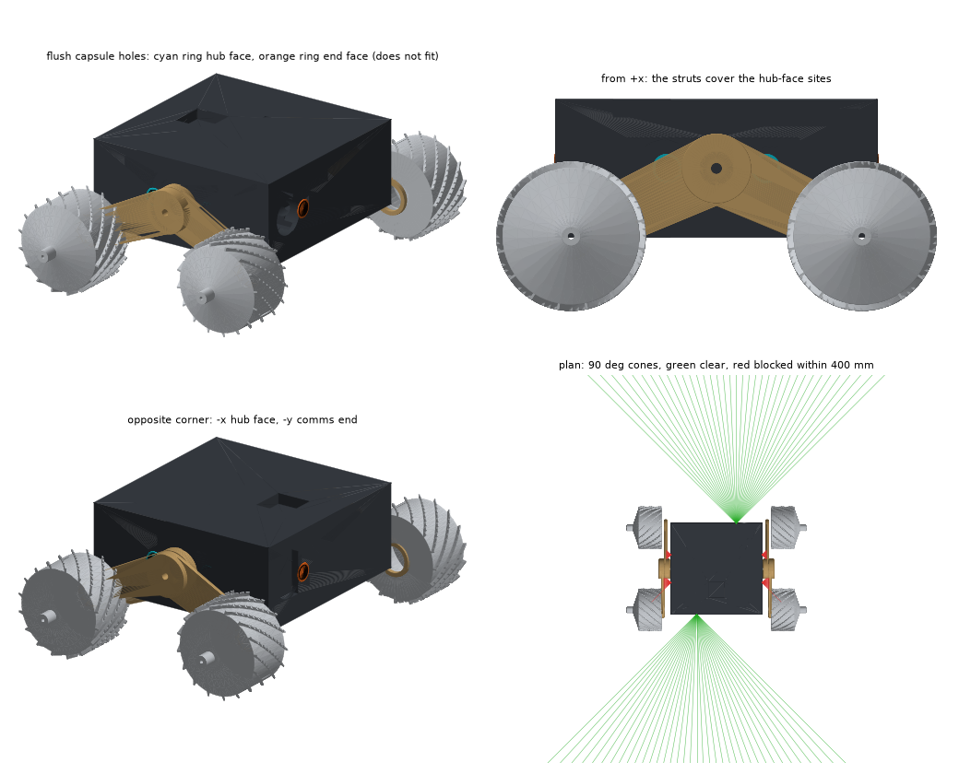
docs/images/ultrasonic-sites.png
