jacob-rn-wallace/jpl-nanorover/hardware/body/out/cell_diagram_ixolar.png

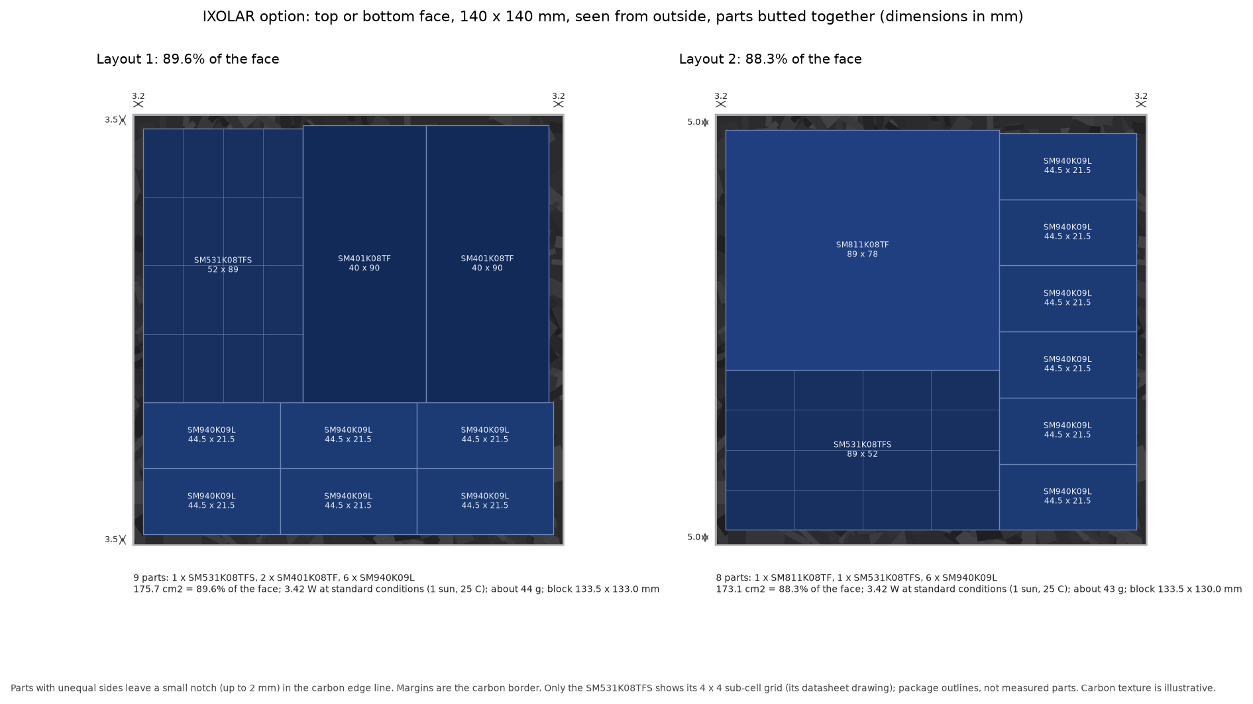
hardware/body/out/cell_diagram_ixolar.png
