jacob-rn-wallace/jpl-nanorover/hardware/body/out/cell_endface.png

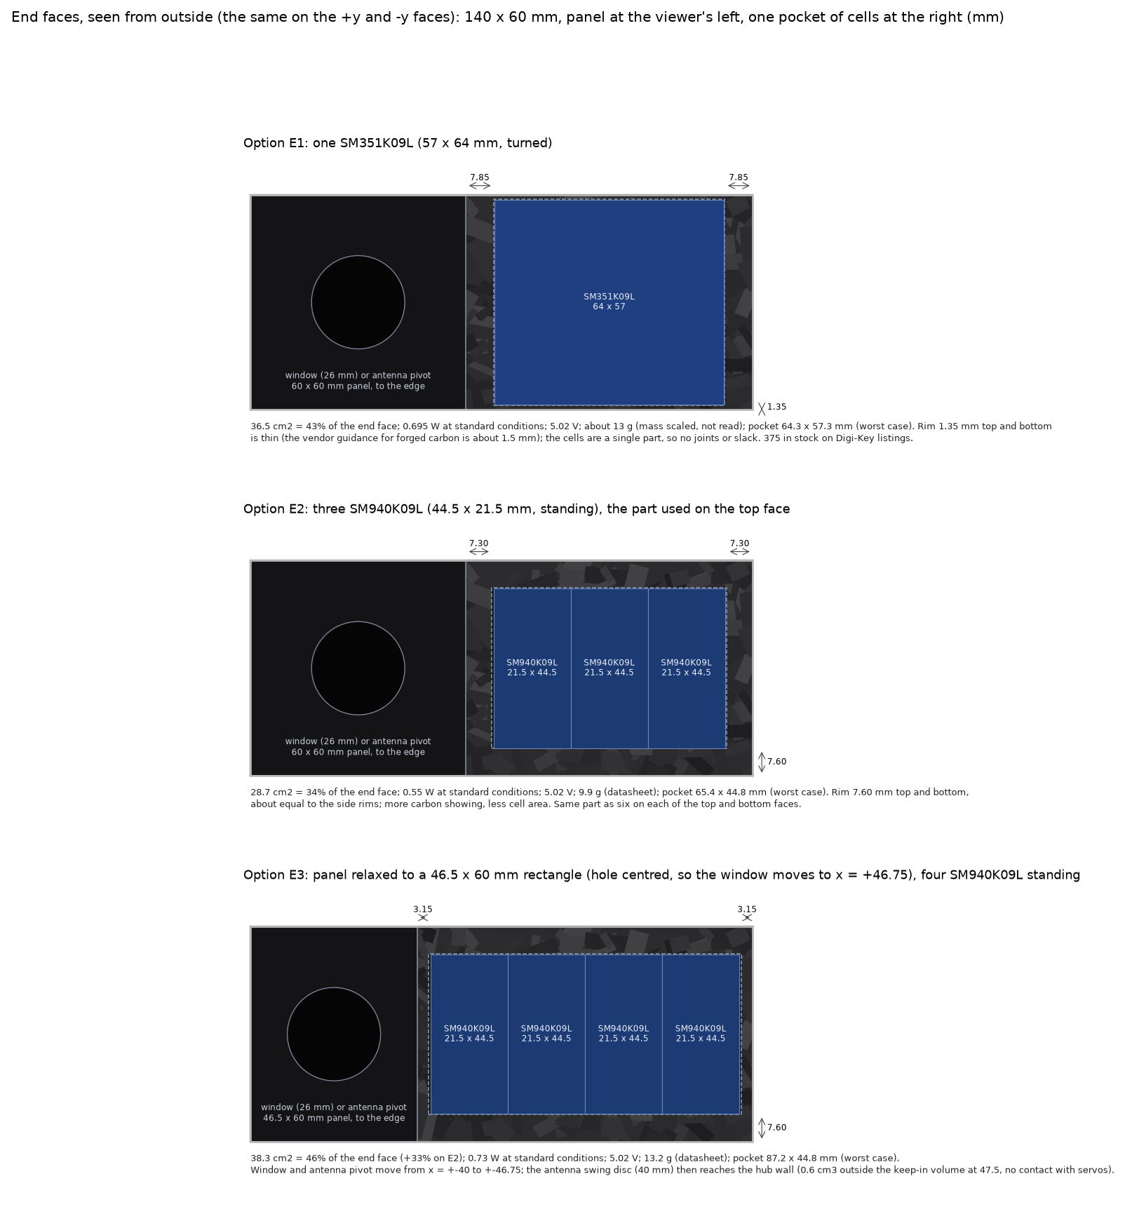
hardware/body/out/cell_endface.png
