jacob-rn-wallace/jpl-nanorover/hardware/body/out/cell_endface_final.png

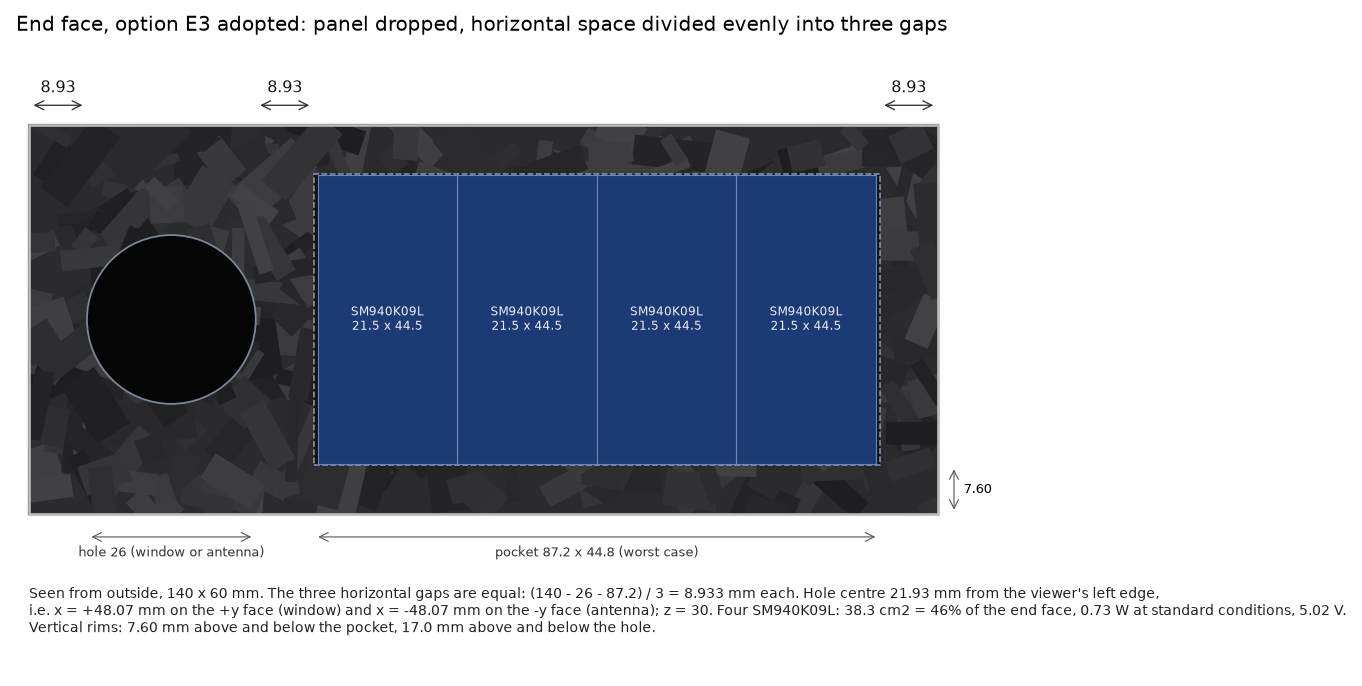
hardware/body/out/cell_endface_final.png
