jacob-rn-wallace/jpl-nanorover/hardware/body/out/cell_pocket.png

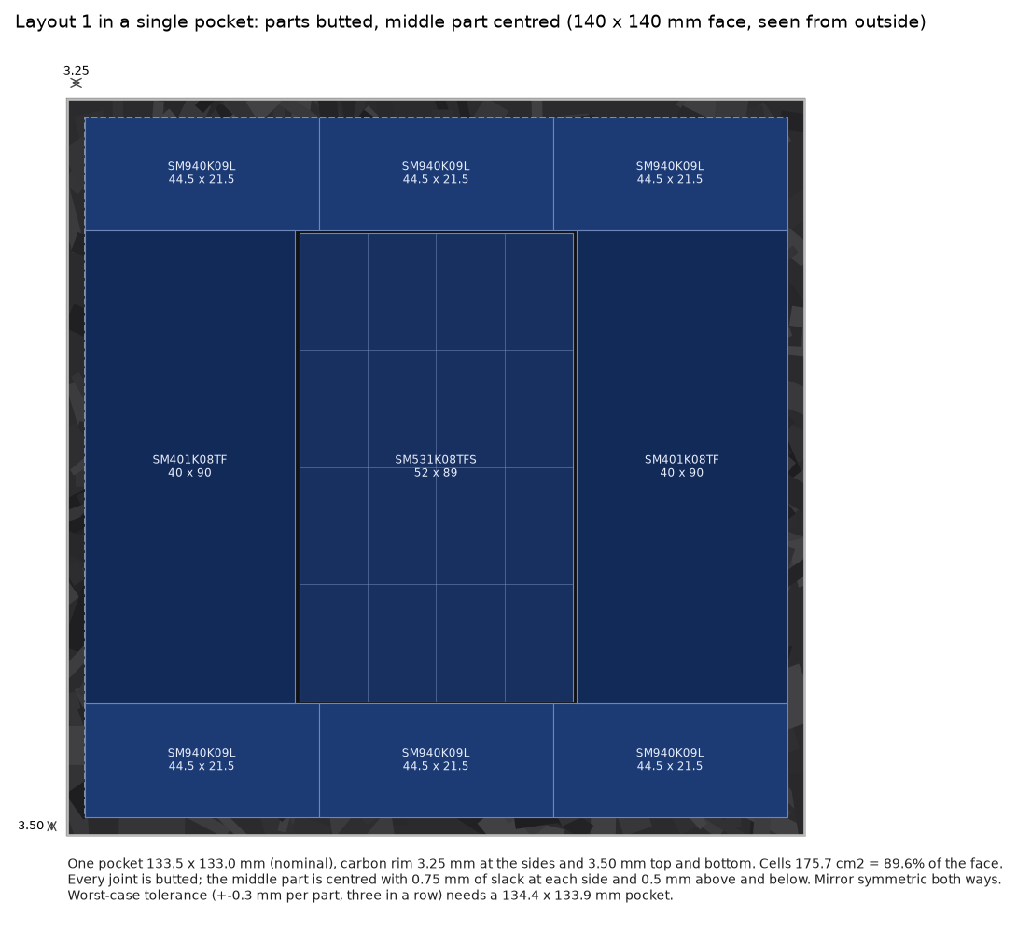
hardware/body/out/cell_pocket.png
