jacob-rn-wallace/jpl-nanorover/hardware/body/out/cell_spread_symmetric.png

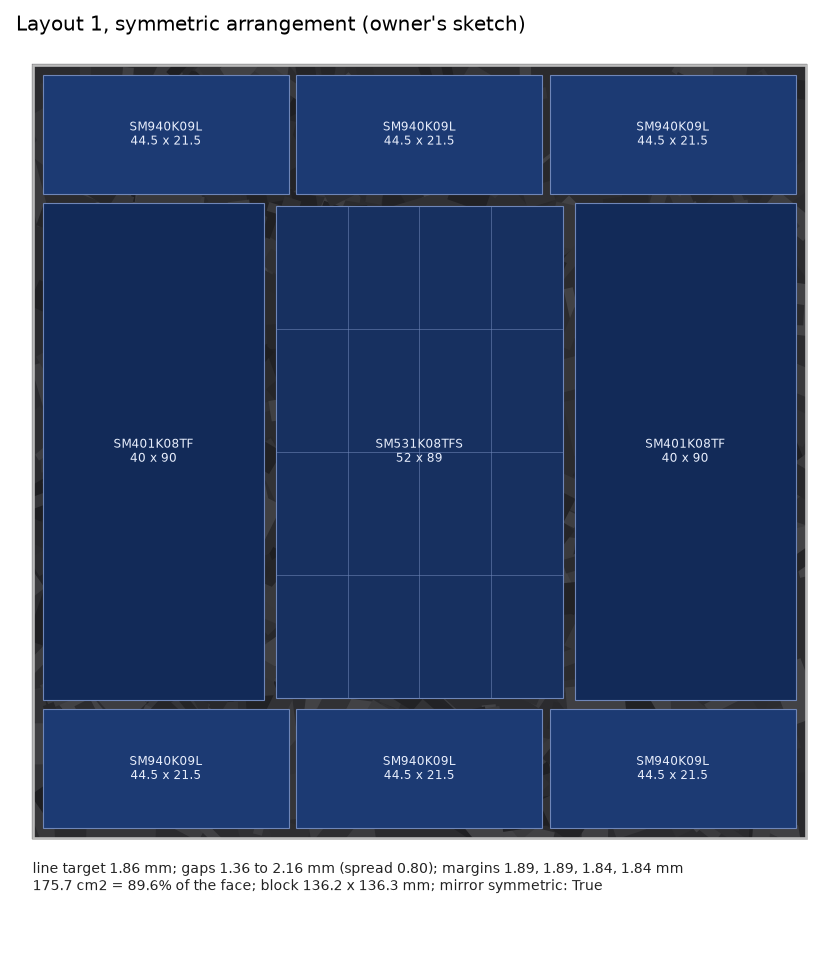
hardware/body/out/cell_spread_symmetric.png
