jacob-rn-wallace/jpl-nanorover/hardware/body/out/optics_top_view.png

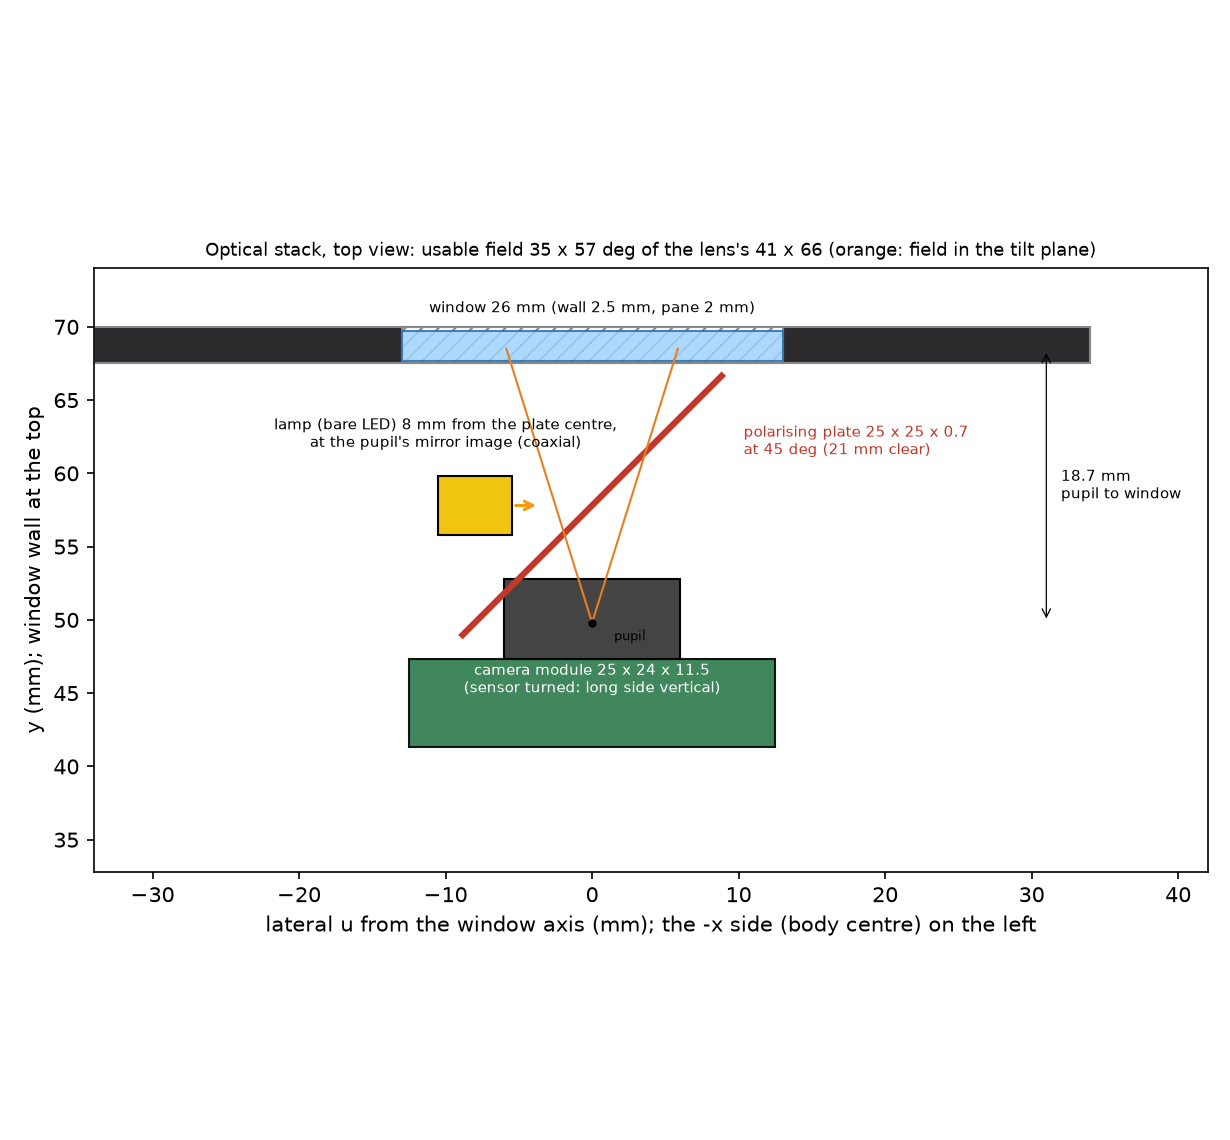
hardware/body/out/optics_top_view.png
