jacob-rn-wallace/jpl-nanorover/hardware/body/out/body_block.step

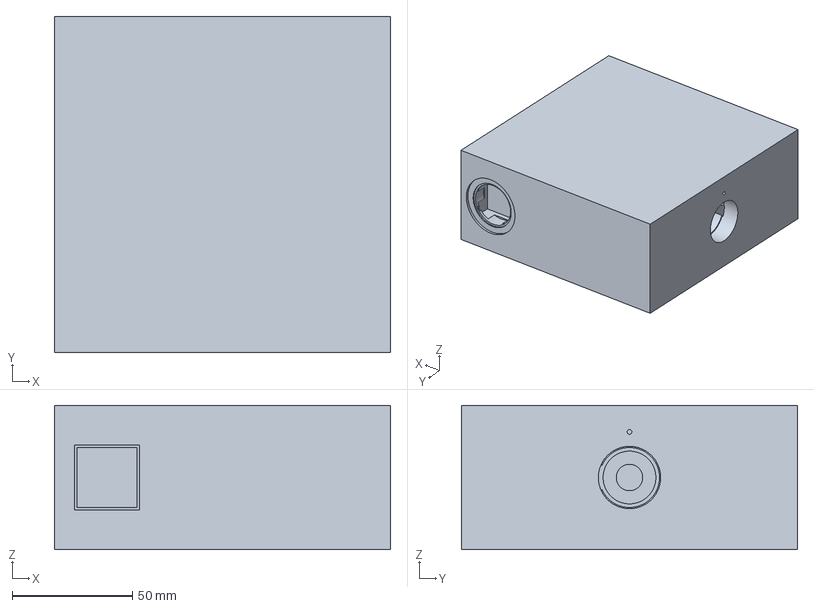
[picture p23: CAD file, 2026-11-14]
hardware/body/out/body_block.step
140.0 x 140.0 x 60.0 mm
