jacob-rn-wallace/jpl-nanorover/hardware/hub/out/hub_housing.step

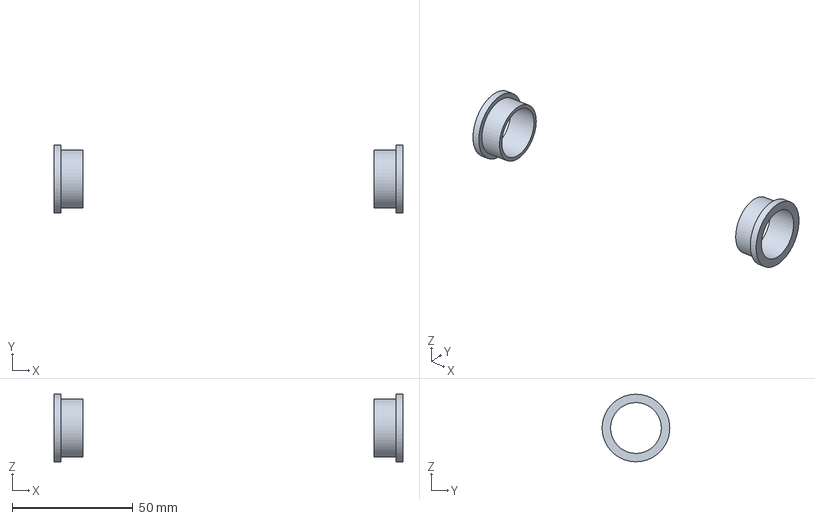
[picture p24: CAD file, 2026-11-14]
hardware/hub/out/hub_housing.step
144.5 x 28.0 x 28.0 mm
