jacob-rn-wallace/jpl-nanorover/hardware/strut/out/wheel_bearings.step

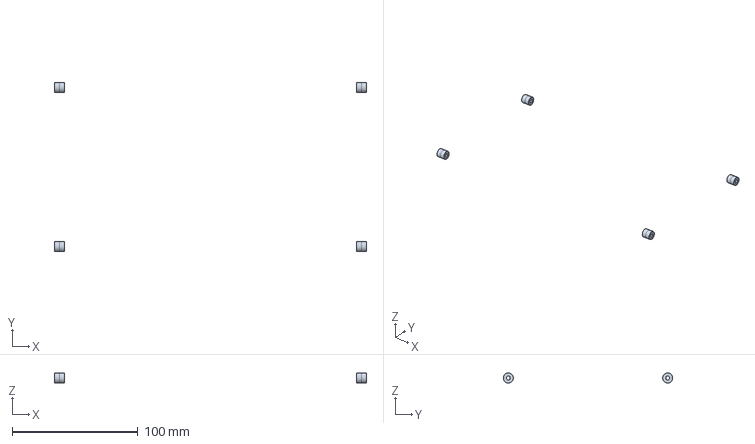
[picture p25: CAD file, 2026-11-14]
hardware/strut/out/wheel_bearings.step
248.5 x 134.9 x 8.00 mm
