jacob-rn-wallace/jpl-nanorover/hardware/wheel/out/wheels.step

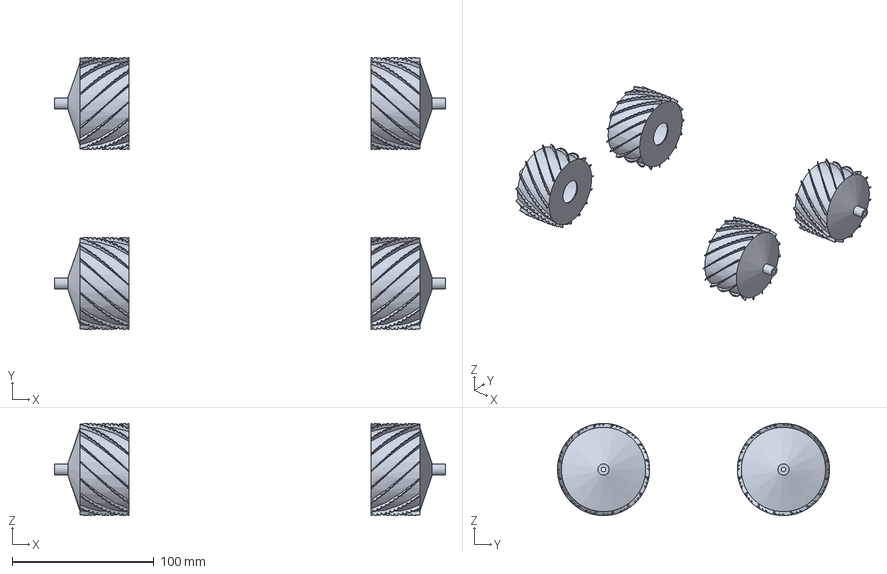
[picture p26: CAD file, 2026-11-11]
hardware/wheel/out/wheels.step
275.7 x 191.9 x 65.0 mm
