jacob-rn-wallace/jpl-nanorover/hardware/body/out/window_pane.step

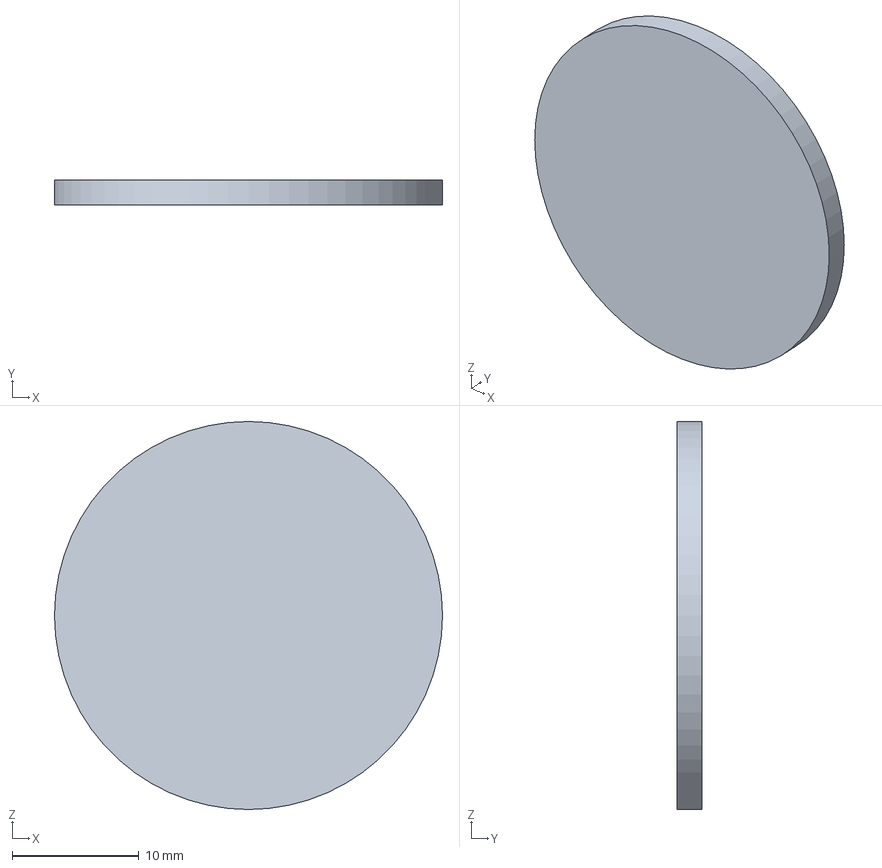
[picture p27: CAD file, 2026-11-14]
hardware/body/out/window_pane.step
30.6 x 2.00 x 30.6 mm
