jacob-rn-wallace/jpl-nanorover/hardware/hub/out/hub_shafts.step

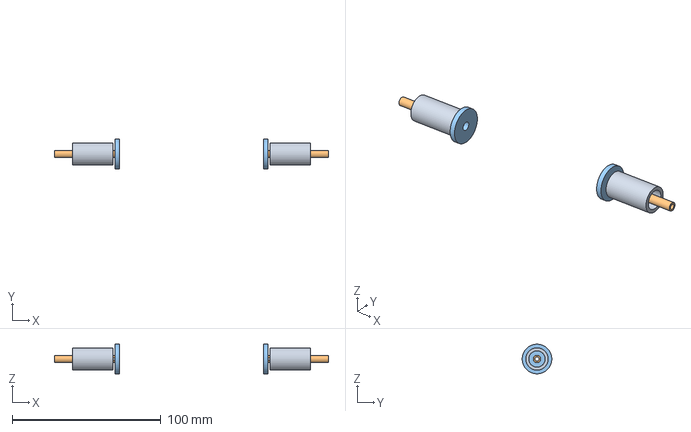
[picture p28: CAD file, 2026-11-14]
hardware/hub/out/hub_shafts.step
184.5 x 20.0 x 20.0 mm
