jacob-rn-wallace/jpl-nanorover/hardware/strut/out/wheel_motors.step

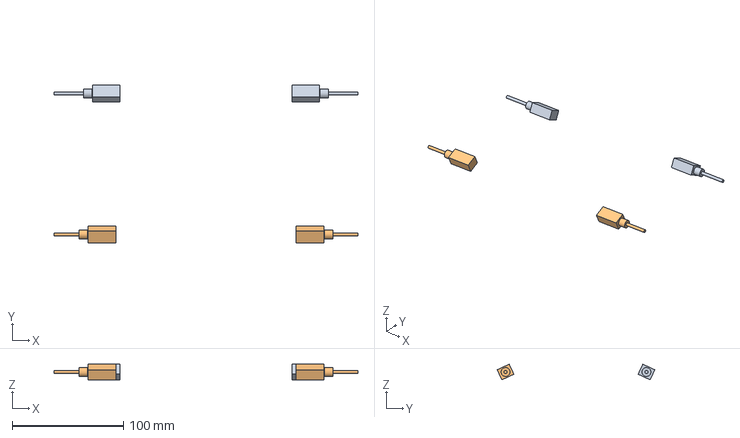
[picture p29: CAD file, 2026-11-14]
hardware/strut/out/wheel_motors.step
273.7 x 142.0 x 14.1 mm
