jacob-rn-wallace/jpl-nanorover/hardware/body/out/lid_plate.step

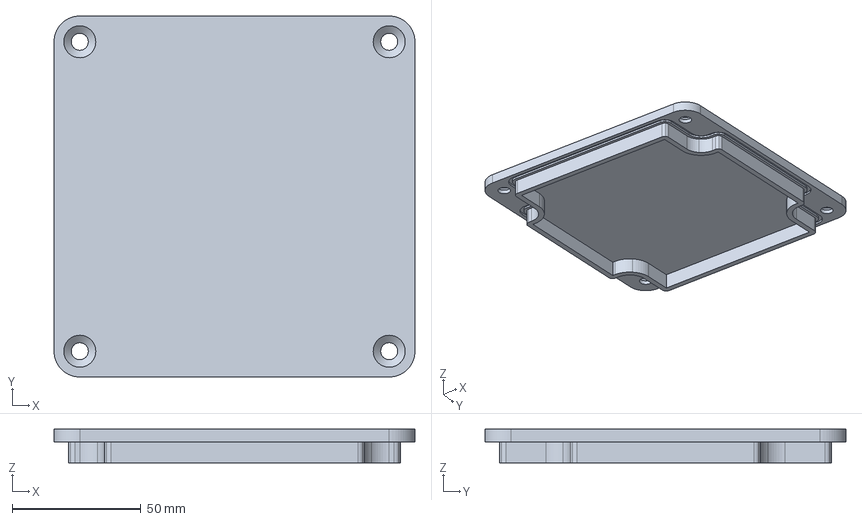
[picture p30: CAD file, 2026-11-14]
hardware/body/out/lid_plate.step
140.0 x 140.0 x 13.0 mm
