jacob-rn-wallace/jpl-nanorover/hardware/hub/out/hub_bearings.step

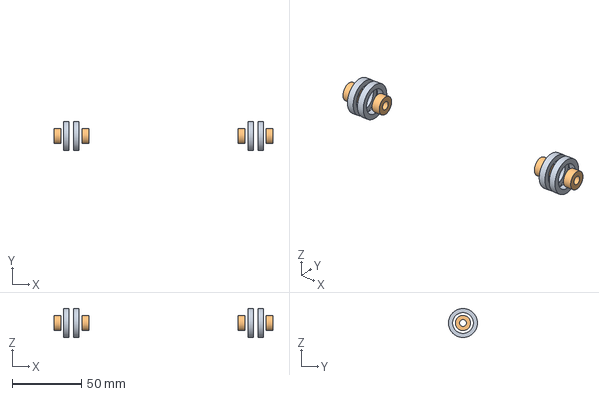
[picture p31: CAD file, 2026-11-14]
hardware/hub/out/hub_bearings.step
158.5 x 21.0 x 21.0 mm
