jacob-rn-wallace/jpl-nanorover/hardware/strut/out/struts.step

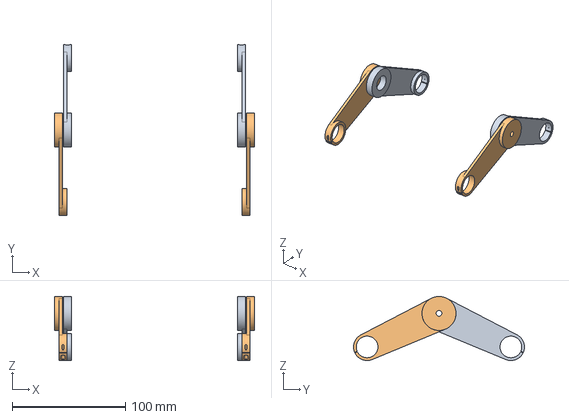
[picture p32: CAD file, 2026-11-14]
hardware/strut/out/struts.step
176.5 x 150.9 x 56.6 mm
