jacob-rn-wallace/jpl-nanorover/hardware/body/out/oring.step

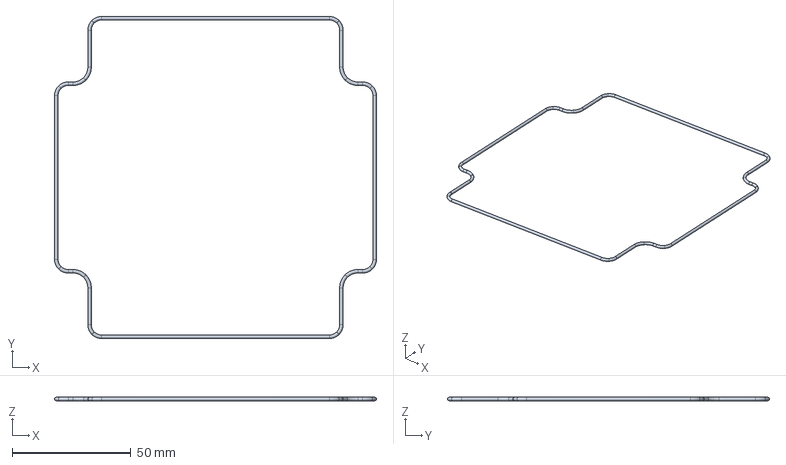
[picture p33: CAD file, 2026-11-14]
hardware/body/out/oring.step
135.4 x 135.4 x 1.50 mm
