jacob-rn-wallace/jpl-nanorover/hardware/hub/out/hub_gears.step

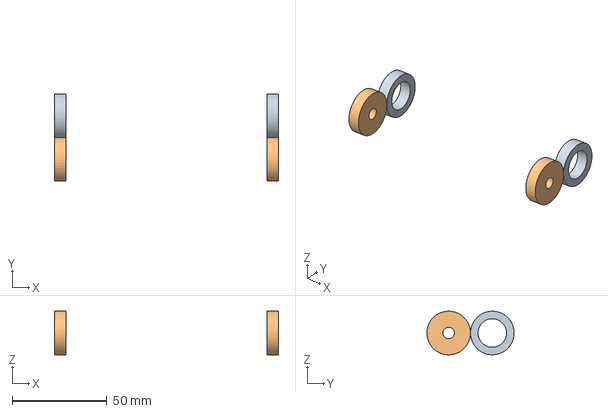
[picture p34: CAD file, 2026-11-14]
hardware/hub/out/hub_gears.step
118.0 x 46.0 x 23.0 mm
