jacob-rn-wallace/jpl-nanorover/hardware/strut/out/wheel_spindles.step

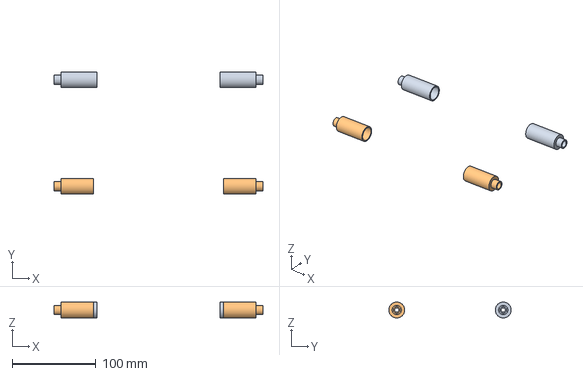
[picture p35: CAD file, 2026-11-14]
hardware/strut/out/wheel_spindles.step
249.0 x 145.9 x 19.0 mm
