jacob-rn-wallace/jpl-nanorover/hardware/body/out/hub_orings_and_nuts.step

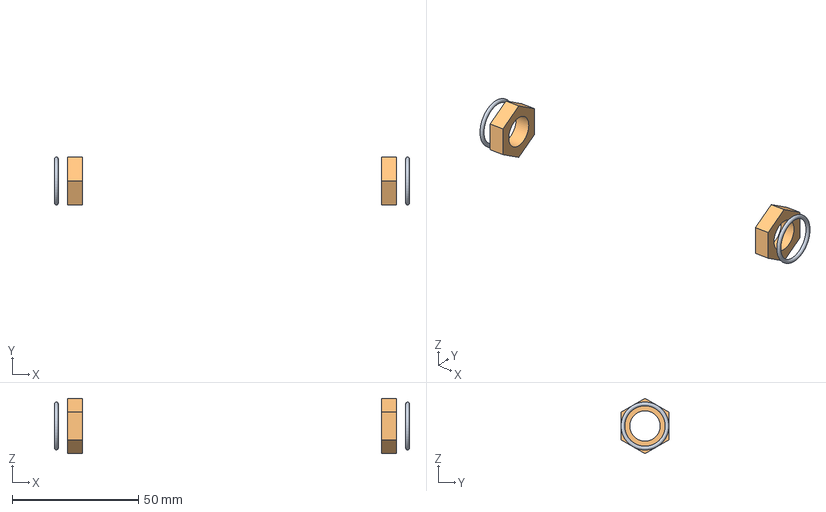
[picture p36: CAD file, 2026-11-14]
hardware/body/out/hub_orings_and_nuts.step
140.7 x 19.0 x 21.9 mm
