jacob-rn-wallace/jpl-nanorover/hardware/hub/out/strut_servos.step

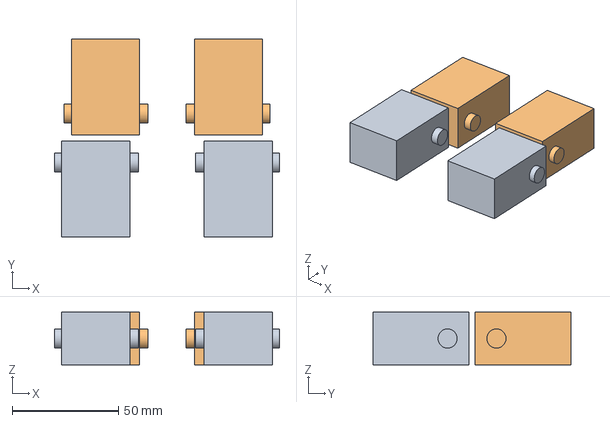
[picture p37: CAD file, 2026-11-14]
hardware/hub/out/strut_servos.step
105.8 x 93.1 x 24.7 mm
