jacob-rn-wallace/jpl-nanorover/hardware/body/out/hub_studs.step

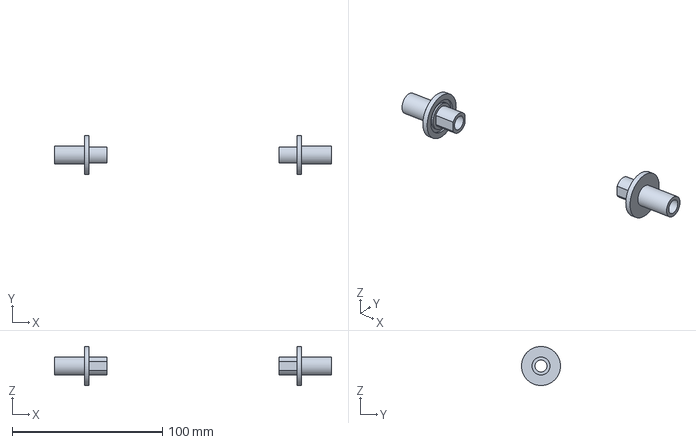
[picture p38: CAD file, 2026-11-14]
hardware/body/out/hub_studs.step
184.5 x 26.0 x 26.0 mm
