jacob-rn-wallace/jpl-nanorover/hardware/body/out/inserts.step

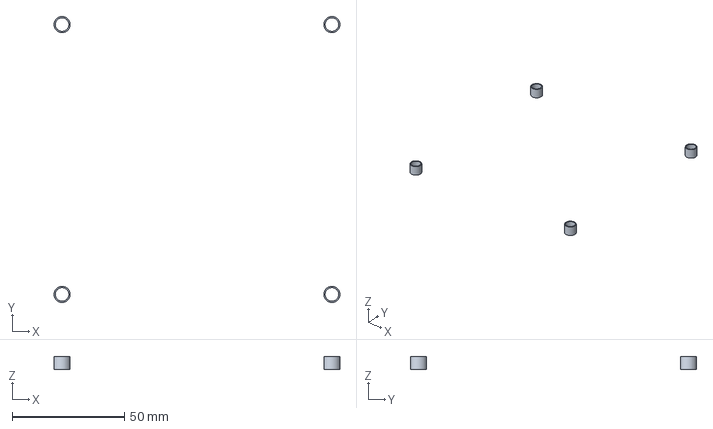
[picture p39: CAD file, 2026-11-14]
hardware/body/out/inserts.step
127.2 x 127.2 x 6.00 mm
