jacob-rn-wallace/jpl-nanorover/(commit log)

2026-11-10 README: count the camera as a function; articulation is a goal, not undecided
    Claude-Session: https://claude.ai/code/session_01B6dv3QuHVS7hsLwZuvmfHM
2026-11-10 Move the CAD work here: body, struts, wheels and assembly scripts, specs, photo measurements, CLAUDE.md
    Hammond's STEP file and anything containing its geometry stay out of the repository (see NOTICE.md); the scripts read the file from the private companion repo.
    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
    [hub_orings_and_nuts.step, hub_studs.step, inserts.step, lid_plate.step, oring.step, struts.step, wheels.step]
2026-11-10 Wheels: conical outer disk on a hollow drum with diagonal saw-tooth grousers, refitted to the second JPL photo
    Replaces the flat disk over stacked saw-blade discs: the cone is real (apex about 10 mm above the rim, seen almost edge-on) and the drum is a twisted ratchet profile with 16 grousers at 43.5 degrees.
    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
    [struts.step, wheels.step]
2026-11-10 Wheels: grousers are thin radial blades along a helix on a smooth cylinder (not a ratchet profile)
    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
    [wheels.step]
2026-11-10 Measure the second photo's end face and model the viewing window
    Window 26 mm across, axis 29 mm from the face edge and 36.8 mm above the base; connector panel, screws and the top block measured and recorded.
    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
    [hub_orings_and_nuts.step, hub_studs.step, inserts.step, lid_plate.step, oring.step, struts.step, wheels.step, window_pane.step]
2026-11-10 Wheel spec: note that the flight wheels in the papers and the 1998 video are banded cylinders, not the cleated prototype wheel
    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
2026-11-10 Record the decision: keep the cleated wheel
    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
2026-11-10 Correct the end-face feature: it is a sealed-beam headlamp, not a connector panel
    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
    [body.py]
2026-11-10 Silver unit becomes the primary reference; viewer's-left convention; its size from the wheels; the black unit's camera aperture
    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
2026-11-10 Record the shared drivetrain and what it implies for the black photo's scale (about 1.11 times the 140 mm assumption)
    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
2026-11-10 Add a note on rovers smaller than the nanorover (the 10-100 g task goal, 'a few ounces', widget boards)
    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
2026-11-11 Record that Figure 1 of the Jones & Wilcox paper is the silver unit, and where the 7 cm strut figure appears
    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
2026-11-11 Correct the scales: the quarter in the first photo gives k = 0.996, so the prototype wheels are about 59 mm and the units' sizes are 139 x 139 (C) and 125 x 140 x 55 (B)
    An earlier version assumed 65 mm wheels and scaled both photos up by 1.11. Co-Authored-By: Claude Sonnet 5.5 <noreply@anthropic.com>
    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
2026-11-11 Wheel spec: the 1998 video is now an .mp4 in the private repo
    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
2026-11-11 Drivetrain: torque and mass budget, motor choices, layout study; layout C chosen
    Owner decisions (2026-11-11): the replica must lift itself under Earth gravity, design mass 1.0 kg total, metal wheels, layout C (wheel motor inside a thin-walled aluminium wheel, strut motors in the body).
    - docs/drivetrain-spec.md: requirement, torque budget, maxon motor candidates read from the 2025/26 catalogue, wheel mass options, speed estimated from the videos (about 20 to 50 mm/s), option C clearance, belt and friction-pivot layouts compared
    - hardware/drivetrain/: torque_budget.py, wheel_mass.py, layouts.py (pure Python), motor_clearance.py and render_compare.py (build123d; the render uses a plain box,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
    [layouts.py, motor_clearance.py, render_compare.py, torque_budget.py, wheel_mass.py]
2026-11-11 Model layout C: thin-walled wheel presets, strut tips bored for the wheel motor
    - wheel.py: PRESETS "thin" (default; 1.0 mm wall, 0.8 mm cone and blades, no hub tube, motor hole and shaft boss, 34 g) and "v1" (the first model, 78 g), switched with use_preset()
    - strut.py: TIP_MODE "motor" (default) bores the strut tips and builds the wheel motors (ECX SPEED 10 M + GPX 10 A, 10 x 44.9 mm, 20.2 g) as out/wheel_motors.step; "axle" keeps the 6 mm stub. Same-hub check includes the motors; no overlaps with body, studs, struts or wheels
    - assembly/rover.py counts the motors (1338 g total with the old box; no strut motors yet)
    - drivetrain scripts use the shared model (motor_clearance.py, render_com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
    [struts.step, wheel_motors.step, wheels.step]
2026-11-11 Switch the wheel motor to the Pololu #3068; record the cost, thermal and isogrid studies
    Motors reconsidered on cost (maxon over $200 each, owner): wheels Pololu #3068 (10 x 12 x 25 mm, 9.5 g, $26.45), struts Feetech ST3215 (not yet in the CAD).
    - strut.py: wheel motor is the #3068 as a 10 x 12 x 25 mm box in a 10.1 x 12.1 mm slot in each strut tip (thermal clamp: the strut is the heat sink); tip boss 20 mm; optional ISOGRID (off by default)
    - wheel.py: 16.5 mm motor hole in the end plate; assembly counts the 9.5 g motors (1296 g total with the old box)
    - drivetrain scripts: motor_options.py (cost and torque comparison of maxon, Feetech, Pololu #3046/#3068, 130-size and PCB-motor notes), is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
    [struts.step, wheel_motors.step, wheels.step]
2026-11-11 Design the wheel support: spindle tube, two bearings, stub shaft and coupling
    The Pololu #3068's 9 mm shaft has a practical radial limit of 0.25 to 0.5 kgf against 0.25 kgf of static wheel load, so the motor cannot carry the wheel.
    - strut.py: a 19 mm spindle tube (OD 19 / ID 16.2) with cap and 11 mm barrel is clamped in a 19.1 mm bore in each strut tip (tip boss 24 mm); the motor sits inside; two 3 x 8 x 4 mm bearings in the barrel carry a 3 mm stub shaft driven through an assumed coupling. New parts: wheel_spindles.step, wheel_bearings.step; wheel_motors.step now has the coupling and stub shaft
    - wheel.py: 20.5 mm end-plate hole around the tube; checks against spindles and bearings (all z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
    [struts.step, wheel_bearings.step, wheel_motors.step, wheel_spindles.step, wheels.step]
2026-11-11 Wheel support: start each strut's tube flush with its own plate, bearings side by side
    Outer struts' tubes stood 4 mm proud behind plate B, in the gap toward the body (pointed out by the owner). Each strut's support now starts at the inboard face of its own plate (A 77.25, B 81.25).
    - strut.py: tail_for(), per-strut tail for motor() and spindle(); cap at 116.25 for both, bearings side by side (4 mm span), barrel to 124.5, coupling 7.5 mm (tight, assumed); bearings kept as separate solids and flattened for the checks
    - all checks zero: 0 of 30 solid pairs overlap at the default pose, 0 of 144 strut-vs-support pairs; assembly 1351 g
    - specs updated (loads recomputed: about 9 N per bearing sta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
    [struts.step, wheel_bearings.step, wheel_motors.step, wheel_spindles.step, wheels.step]
2026-11-11 Coaxial strut hub with Feetech STS3215 servos
    Two servos per side drive the two struts through concentric shafts: servo B on the hub axis drives a 5 mm inner shaft (outermost strut B); servo A, offset 23 mm, drives a 15/11 mm hollow shaft (inboard strut A) through a 1:1 spur pair. A stationary housing through the wall carries two 6702-size bearings; two 685-size bearings run between the shafts.
    - hardware/hub/hub.py: parts and checks; servo dimensions from the Feetech STS3215 specification (45.23 x 24.73 mm, 55 g, shaft out of both faces; the shaft offset is read by eye from the drawing)
    - strut.py: HUB_MODE "coaxial" (default) with 15.05 mm and 5.05 mm pivot bores; "stud" keeps the earlier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
    [hub_bearings.step, hub_gears.step, hub_housing.step, hub_shafts.step, strut_servos.step, struts.step, wheel_bearings.step, wheel_motors.step]
2026-11-11 Chassis simulation, and the write-up of the drivetrain session
    Planar quasi-static simulation of the four-strut chassis (hardware/drivetrain/chassis_sim.py, docs/chassis-simulation.md): stances, tip-over margins, per-strut torque, and self-righting from inverted. Validated against the CAD's 32.1 mm floor clearance at the 25 degree stance.
    Findings
    - the strut load is half what the motor and gear sizing used: hold at 25 degrees is 0.11 to 0.12 N.m per strut and the maximum over every stable pose is 0.166 N.m (about 0.33 N.m with margin 2), against 0.34 and 0.69 N.m before; the wheels, struts and supports rest on the ground and do not load the joints
    - the rover can right itself from inverted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
    [hub_bearings.step, hub_gears.step, hub_housing.step, hub_shafts.step, strut_servos.step, struts.step, wheel_bearings.step, wheel_motors.step]
2026-11-11 Add photo_compare.py: render the CAD from the silver unit photo's camera
    Claude-Session: https://claude.ai/code/session_01B6dv3M1QygXiNnSEJcRBxb
2026-11-11 Alternate wheel handedness: front and rear opposite on a side, the other side mirrored
    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
    [wheels.step]
2026-11-11 Record that the owner confirmed the alternating wheel handedness on the side-by-side render
    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
2026-11-11 STS3215: measure the shaft offset on the Feetech drawing (10.2 mm, was 10.7 by eye); the 32 mm height is a printed dimension
    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
    [hub_bearings.step, hub_gears.step, hub_housing.step, hub_shafts.step, strut_servos.step]
2026-11-11 Body redesign: carbon fibre or forged carbon (owner); mass budget script and design record
    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
    [cf_budget.py]
2026-11-11 Body redesign: sourced comparison of woven and forged carbon, with project numbers (cf_compare.py)
    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
    [cf_compare.py]
2026-11-11 Body redesign: sourced comparison of woven and forged carbon, with project numbers
    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
    [cf_compare.py]
2026-11-11 Body redesign: consumer-crisp edges (owner) favour bonded flat plates over a layup tub
    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
2026-11-11 Body redesign: cost comparison of bonded woven plates and forged carbon in printed moulds (cf_cost.py)
    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
    [cf_cost.py]
2026-11-11 Body redesign: defer the carbon choice; interior layout with keep-in volume, placements, mass and balance checks (layout.py)
    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
    [layout.py]
2026-11-11 Body redesign: owner's layout decisions (identical top/bottom lids, shared camera and lamp window, gravity-oriented antenna), power study and revised layout
    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
    [layout.py, power_budget.py]
2026-11-11 Body redesign: solid-block-with-cavities model (block.py): cavities cut as CAD, skin and lining mass by cavity group
    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
    [body_block.step]
2026-11-12 Body redesign: record owner's process, forged-carbon lean and outside-only machining route
    Process order (placement, attachment points, cavities, access points,
    topology optimisation, fabrication refinement), the meteorite-texture lean
    toward forged carbon, precedents found, and the mould-then-machine-outside idea.
    Claude-Session: https://claude.ai/code/session_01B6dv3Qvi4h1rg7PThFYCTc
2026-11-13 Body: forged carbon assumed; IXOLAR cell layout, end faces, optical stack, scripts updated
    Cells: the symmetric nine-part IXOLAR arrangement in one pocket per face (worst-case tolerance), the end face with four SM940K09L and three equal gaps (window and antenna at x = +-48.07). Optical stack: a 25 mm polarising plate behind the 26 mm window, M12 lens ray trace (optics.py). layout.py and block.py use the new positions, the real cell masses, forged shell only and a 38 mm antenna disc; mass deferred (425 g against 386 g). Cell study scripts and pictures (cell_catalogue, cell_layout, cell_split, cell_spread, cell_pocket, cell_diagram, cell_endface).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
    [body_block.step]
2026-11-13 Docs: electronics concept and research on the era of robotics
    The owner's guiding principle (the spirit of the Handy Board and CMUcam era, for parts selection only; a teleoperated rover like a PackBot), the Sojourner cyclic executive and hazard definitions, the operator view (a map built on the console plus stills at slow-scan speed), processor, camera, radio and bandwidth findings, and the open decisions.
    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
2026-11-13 Simulation: operator-console vertical slice (three.js, Vite, TypeScript)
    A browser app, modelled on maha-rover's, to test whether driving the rover through a low-fidelity 3D map with photographs on request is fun: an indoor tabletop arena, a range-sensor and odometry model, the rover's cyclic-executive firmware with Sojourner's hazards and a risk level, a radio link in which photos slow the map, and the operator console. 21 logic checks (npm run check); spec and findings in docs/sim-spec.md; GitHub Pages workflow as in maha-rover.
    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
2026-11-13 Simulation: map-quality measure, persistent hazards, redrawn map view; handover section 15
    First play-test: the operator map was the weak point. tests/map-check.ts (npm run map)
    measures recall and precision of the map against the true world. consoleMap: persistent
    hazard evidence, gap filling, an (ineffective) scan-matching correction. consoleView and
    main: flatter and paler map, flat drop-off marks, rock plateaus, sensor cone, fading trail,
    spectator view off/small/large. The redraw has not been looked at yet. Docs: sim-spec
    findings, handover section 15 (next focus: absolute positioning or minimal drift in hardware).
    Claude-Sessio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
2026-11-13 Antennas: 2.4 GHz patch and GNSS replace the pendulum whip; layout, block and docs updated
    Outdoor use is a goal, a modern GNSS module and a 2.4 GHz serial radio are accepted.
    layout.py and block.py: comms patch behind an RF window, one GNSS patch per lid,
    receiver module on z = 30 (placeholders); body contents 437 g against 386 g.
    [body_block.step]
2026-11-13 Docs: positioning precedents checked by search; correct the ultrasonic beacon accuracy to 3 to 5 cm
2026-11-13 Sim: gyro calibration at stops, tilt noise setting, ultrasonic beacon and Lighthouse 1.0 fixes, pose-error check; ultrasonic site render
    [ultrasonic_render.py]
2026-11-13 Positioning: ultrasonic site check, Lighthouse via the cells, GNSS dropped, XBee 3 and Taoglas patch chosen, flush 27 mm square comms window; layout, block and docs updated
    [body_block.step]
2026-11-13 Radio power figures: PIC32 plus XBee 3 replace the ESP32-class assumptions; power budget, sim constants, energy check and docs updated
    [power_budget.py]
2026-11-13 Concept render: exterior of the interpreted rover with forged-carbon texture, IXOLAR cells, windows, struts and wheels
2026-11-13 Blender render: Cycles scene with forged-carbon body, bare aluminium struts and wheels, near-black matte IXOLAR cells from product photographs; export script, docs and five views
2026-11-13 Hardware spec: battery sizing, 1S 1000 mAh cell, TPS61288 and TPS63802 rails, BQ25185 charger, back-EMF wheel counting; layout battery grown to the full gap; power budget and sim battery energy updat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
    [body_block.step]
2026-11-13 Hardware spec: VL53L5CX power from the datasheet (313 mW continuous), ICM-42688-P and PIC32 pin budget; ranging load added to the power budget
2026-11-13 Hardware spec: DRV8837 wheel drivers with back-EMF sampling, servo bus interface, operator-side XBee, Pololu 3068 ratio corrected to 249:1, PIC32 28-pin pin budget found short
2026-11-13 Controller moves to the 44-pin PIC32MX250F128D: pin budget with wheel drivers, servo bus, sensors and ADC no longer fits the 28-pin part
    [power_budget.py]
2026-11-13 Mechanical spec: wheel set screw, tube clamp, sleeve coupling, labyrinth seals, hub adapters on servo horns, strut service-loop cables and stops; finding that the lids' cell rim leaves no room for fa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
2026-11-13 Ranging sensor placed above the camera window on the end face with an 8 x 10 mm wall window; layout and block updated (body contents now 439 g, over by 53 g)
    [body_block.step]
2026-11-13 Ranging sensor moved behind the camera window: window becomes a 26 x 36 mm stadium under one cover glass, sensor at z = 46 in front of the beamsplitter plate
    [body_block.step]
2026-11-13 Ranging sensor behind the camera window with a larger circular opening (36 mm on the same centre), sensor beside the beamsplitter plate on the camera axis height
    [body_block.step]
2026-11-13 Concept render: 36 mm window with the ranging sensor, near-black cells, window close-up with labels
2026-11-14 Ranging sensor moved to the top segment of a 28 mm window: the camera's rectangular view leaves it free; plate modelled as its slanted slab; the earlier side position vignetted the camera
    [body_block.step]
2026-11-14 Beamsplitter dropped: camera behind the cover glass with a ring of white LEDs round its lens and the ranging sensor in the ring's top slot; window back to 26 mm; lamp load 0.1 W; layout, block, docs,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
    [body_block.step]
2026-11-14 Dead-front film over the LED ring (smoked, about 20%) and IR-passing ink over the ranging sensor so the window reads as one black disc; lamp load 0.25 W; render shows the LEDs off
2026-11-14 Strut pivot checks: clamp strength fine but stiffness and the screw ear need work; cable wrap numbers; strut travel needs about 340 degrees placed asymmetrically (earlier half-turn claim corrected); 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
    [pivot_checks.py]
2026-11-14 Strut stop window check: the asymmetric 340 degree window (-145 to +195 about home) leaves 0.7% of starts within 90 degrees of home stuck; the symmetric +-170 degrees strands half; more travel does n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
    [stop_window_check.py]
2026-11-14 Strut tip clamp in CAD: 4 mm inboard collar, slit and M2 screw hole; interference unchanged; cable routing worked out (A through a spiral ring and a wall hole, B through a hollow inner shaft)
    [hub_bearings.step, hub_gears.step, hub_housing.step, hub_orings_and_nuts.step, hub_shafts.step, hub_studs.step, inserts.step, lid_plate.step]
2026-11-14 Hub: hollow strut B inner shaft with a wire cross hole; side-wall wire feedthroughs in the body block; mechanical spec updated
    [body_block.step, hub_bearings.step, hub_gears.step, hub_housing.step, hub_shafts.step, strut_servos.step]
2026-11-14 Blender renders: camera window with lens hood, lens, dead-front ring over seven LEDs and the ranging sensor under IR ink; new window view; detail and hero re-rendered
2026-11-14 Blender render script: DEVICE=gpu option (Metal on Apple Silicon, CUDA/OptiX/HIP elsewhere, CPU fallback); Mac setup notes with the verified 4.5.9 arm64 checksum
2026-11-14 LED fix (LEDs not drawn when off, LED=on draws them lit), SUFFIX option, render_all.sh, docs/render-jobs.md as the hand-off to the render session; window view re-rendered (457 s on the desktop CPU)
2026-11-14 Datasheet confirmations: DRV8837 coast state and OCP limit (the wheel motor's 1.85 A stall at 7.4 V sits near it), PIC32MX250F128D pin, output-compare and current figures, OC pin groups, BQ29700 prot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
    [power_budget.py]
2026-11-14 Camera end parts: six mid-power white LEDs in three pairs (lamp photometry shows indicator LEDs far too dim), 0.5 mm cover glass with black mask and clear sensor apertures (ST: no coating), lamp load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
    [body_block.step]
2026-11-14 Cover glass: sapphire considered (custom 28 mm by 0.5 mm disc recommended, uncoated first; the stock 25 mm disc and a vacuum-viewport flange do not fit); crosstalk and price trade-offs recorded
2026-11-14 Window bezel: bare aluminium ring flush with the carbon face, six flush countersunk M1.6 screws, sapphire recessed behind it (pocket and seat cut in the block); sensor-to-glass gap now 0.5 mm; Blende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
    [body_block.step]
2026-11-14 Render jobs R8 and R9 (black-oxide bezel variants) added to the job list and render_all.sh; BEZEL=black option; R7 text says six LEDs
2026-11-14 Render R8: window close-up with the black-oxide bezel (the ring and screws nearly vanish against the carbon)
